amichai-bd/riscv-multi-core-lotr/doc/UART_IO_doc/README.md

This folder should contain all the UART_IO documentation
