amichai-bd/riscv-multi-core-lotr/doc/UART_IO_doc/UART_tile.pptx

Oogway UART Tile

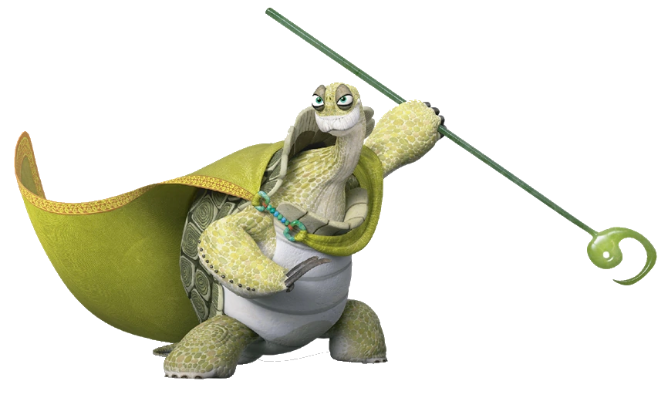
[picture p1: figure]

Chris Shakkour
Shahar Dror

## Introduction

- The UART tile project is a part of a bigger project called the LOTR
- A multi-core design project featuring a ring-like architecture to connect all the cores/tiles in a ring
- the UART tile is here to provide communication from host devices to the LOTR

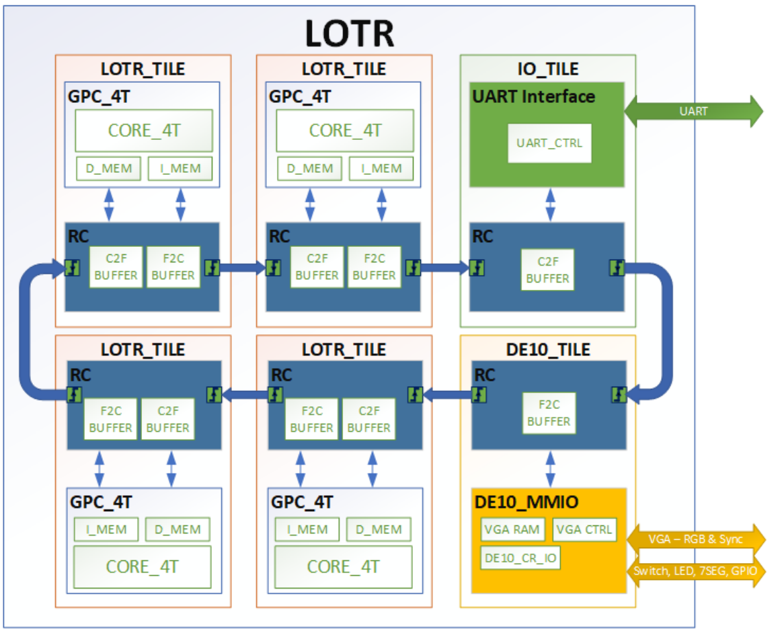
[picture p2: figure]

## System level Connection

The HW interface of the project serves as the blue part in this diagram and the SW interface serves as the green part

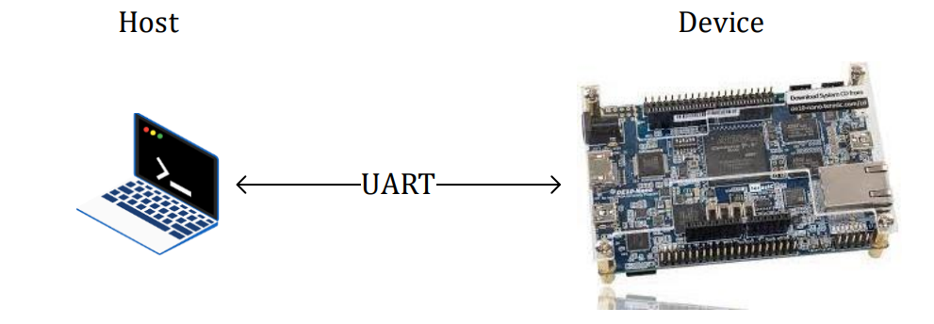
[picture p3: figure]
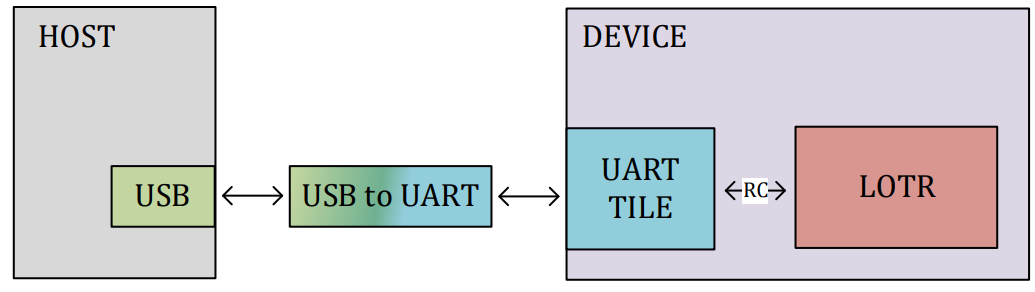
[picture p4: figure]

## Demo

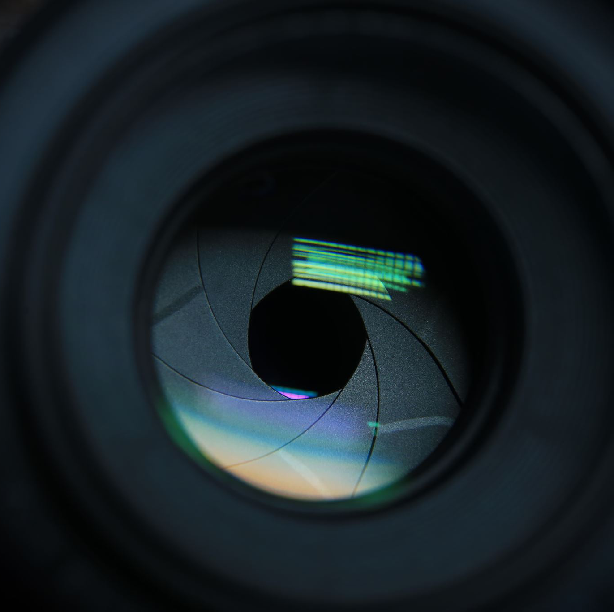
[picture p5: figure]
Camera lens close up

## HW-SW interface

The following diagram shows the different abstraction levels within each interface, both interfaces SW, and HW have multiple abstraction levels as seen below.

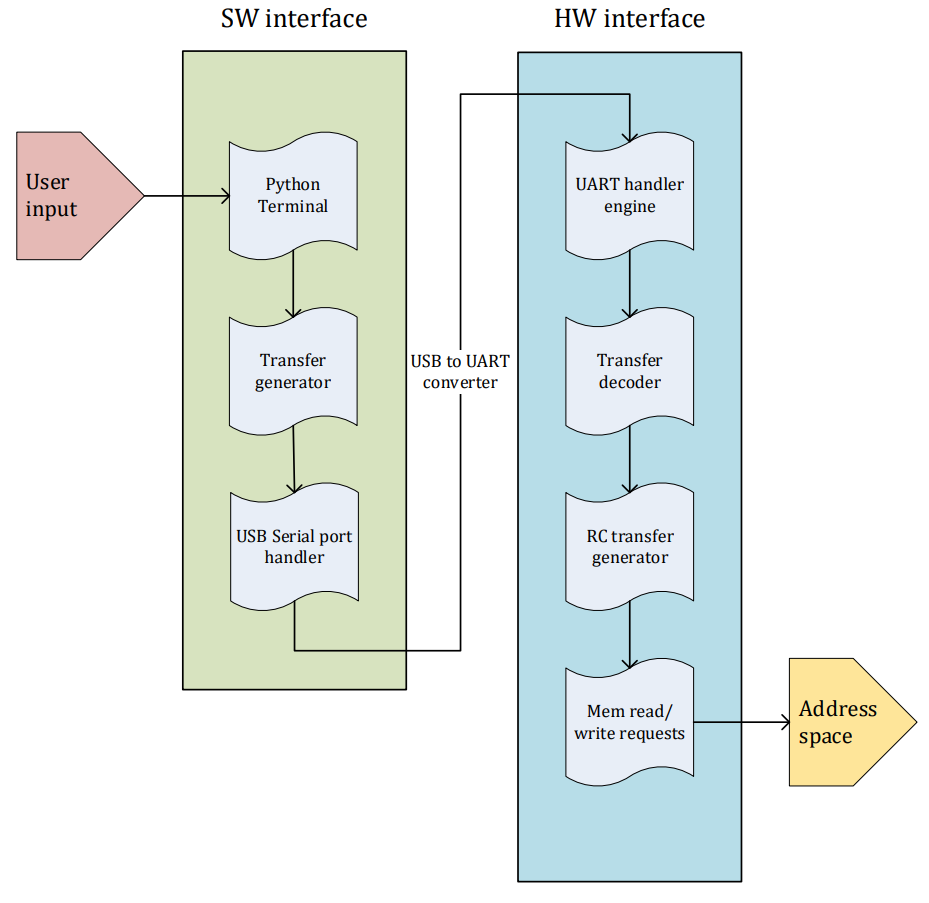
[picture p6: figure]

## SW Interface

- The software interface is the code running on a Host device
- The software does two main functions:
  1. Decode user input.
  2. Generate “Host to Device” transfers.

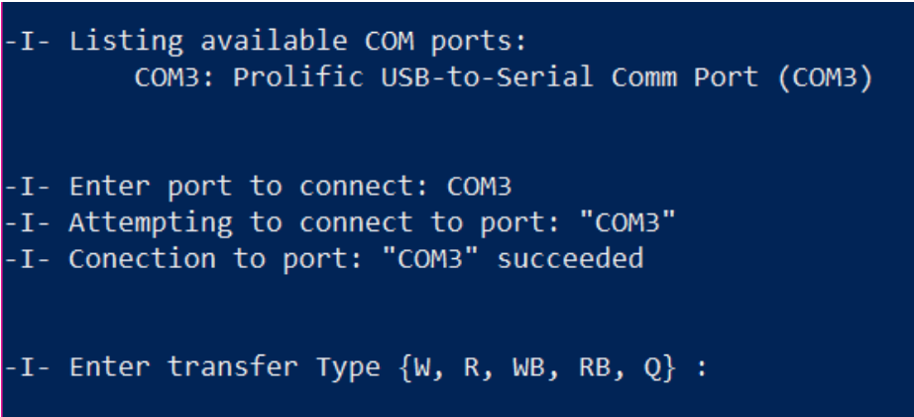
[picture p7: figure]

## Host to Device Transfers

- All transfers are initiated by the Host only.
- The Host starts the transfer and waits for a response from the Device or expire upon timeout.
- Each transfer starts with one byte indicating the transfer type followed by ‘N’ bytes with the required information:
  - transfer address
  - data from Host to Device
- For each transfer, a series of bytes is responded from the Device starting with ‘K’ followed by “M” bytes of response information.

## Write transfer

Initiated by the Host with a starting byte ‘W’, Followed by 8 bytes consisting of, 4 bytes representing the transfer Address, and 4 bytes of transfer data. After a successful transfer, the Device responds with a byte of “K” in ascii indicating transfer completion.

## Read transfer

Initiated by the Host with a starting byte ‘R’, Followed by 4 bytes representing the transfer Address. After a successful transfer, the Device responds with a byte of “K” in ascii indicating transfer completion, followed by 4 bytes of response Data.

## Write burst transfer

Initiated by the Host with a starting byte ‘W’, Followed by Many bytes consisting of, 4 bytes representing the transfer Address, 4 bytes representing the transfer Size and 4*Size bytes of transfer data. After a successful transfer, the Device responds with a byte of “K” in ascii indicating transfer completion.

## Read burst transfer

Initiated by the Host with a starting byte ‘W’, Followed by Many bytes consisting of, 4 bytes representing the transfer Address, 4 bytes representing the transfer Size. After a successful transfer, the Device responds with a byte of “K” in ascii indicating transfer completion, followed by 4*Size bytes of response data.

## Low-level communication diagram

- The transfers are sent in asynchronous serial communication protocols from the host via the USB line and the UART line
- Then translated to reg access transfers passing through the wishbone
- After that the gateway communicates with the RC interfaces
- The way back to the HOST in the opposite direction

## Hardware interface

- The UART tile connects to the Ring using the RC block, the RC block communicates with the Gateway module that acts as a conversion bridge between the UART transfers and the RC transfers.

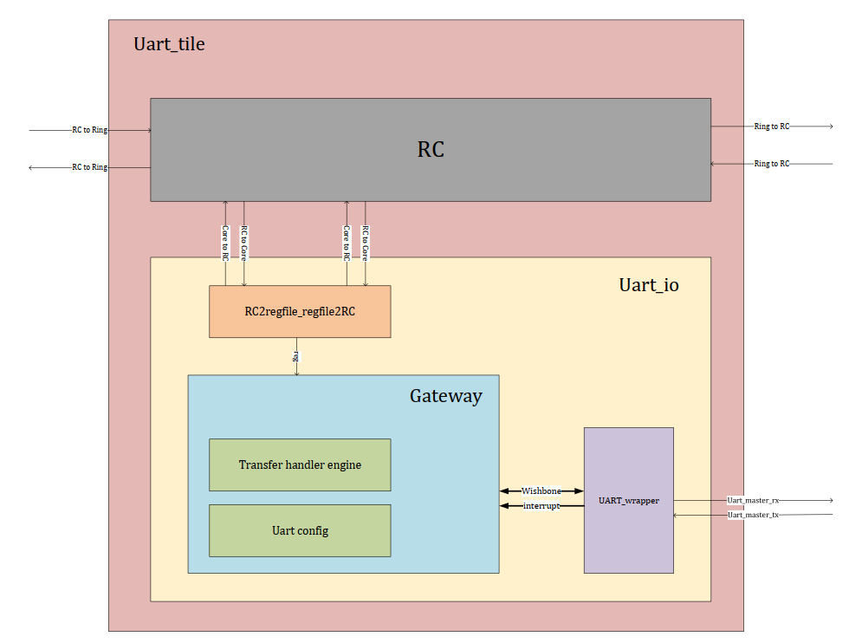
[picture p8: figure]

## Ring controller (IP)

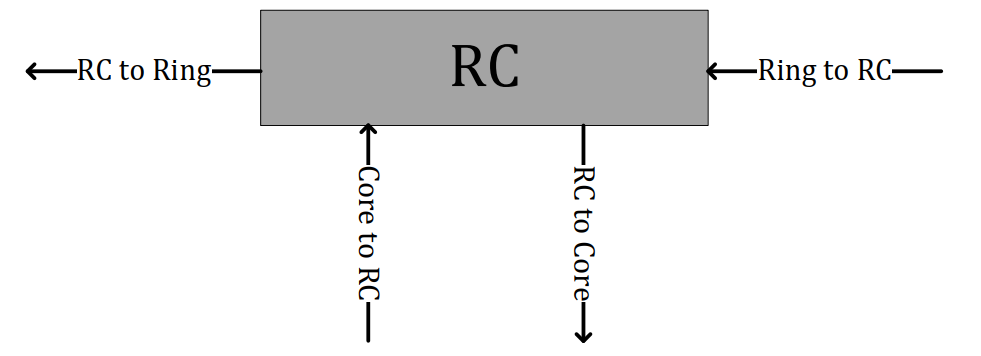
[picture p9: figure]
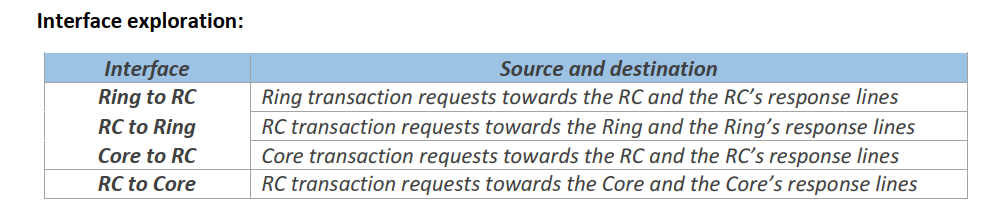
[picture p10: figure]

## Configuration FSM

- An FSM that handles the configuration flow and goes to sleep after config flow is done.
- configuring the UART IP via a series of wishbone reads and writes to set the configuration registers with the desired values:
  - Baudrate
  - word length
  - Interrupt configuration

## Transfer handler engine

- This unit is responsible for decoding the transfers sent by the Host after the translation to wishebone
- The FSM to convert them to direct access register transfers.
- The address and data information are sent in parallel in a single cycle to the Reg2rc conversion unit that then moves this transfer forward to the RC controller

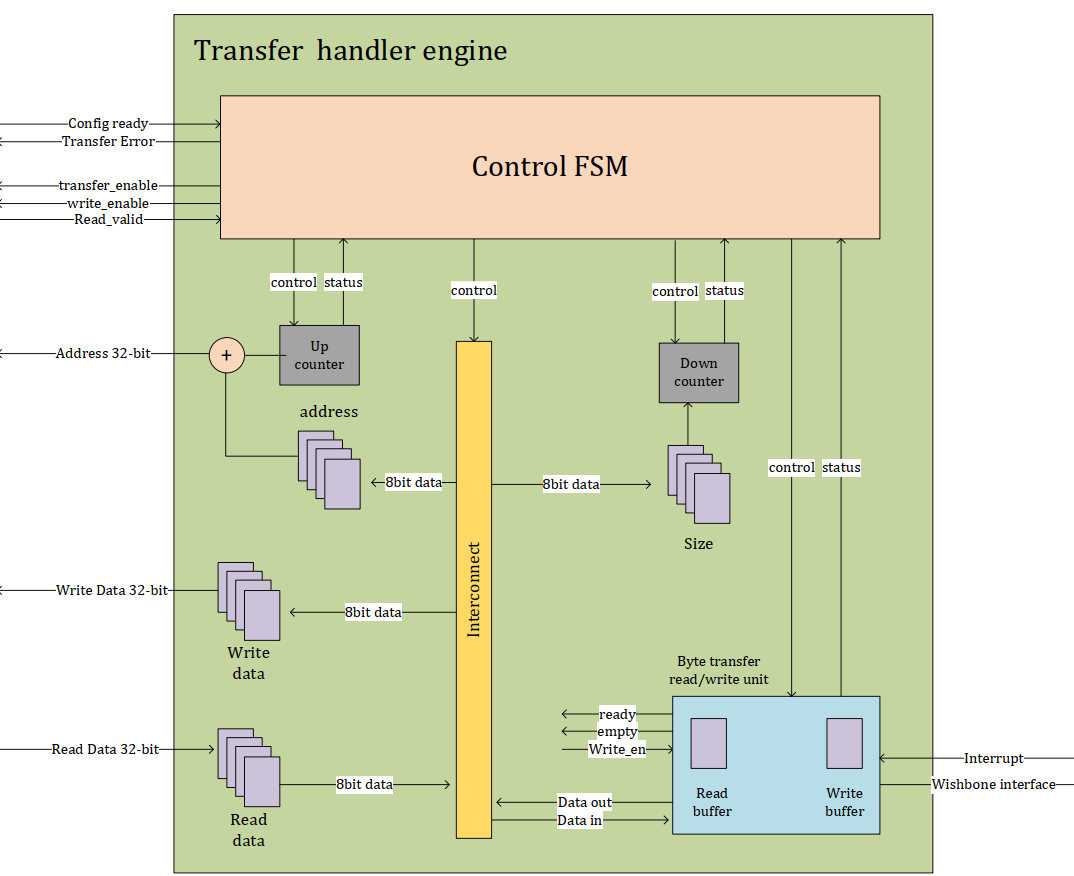
[picture p11: figure]

## FSM examples write

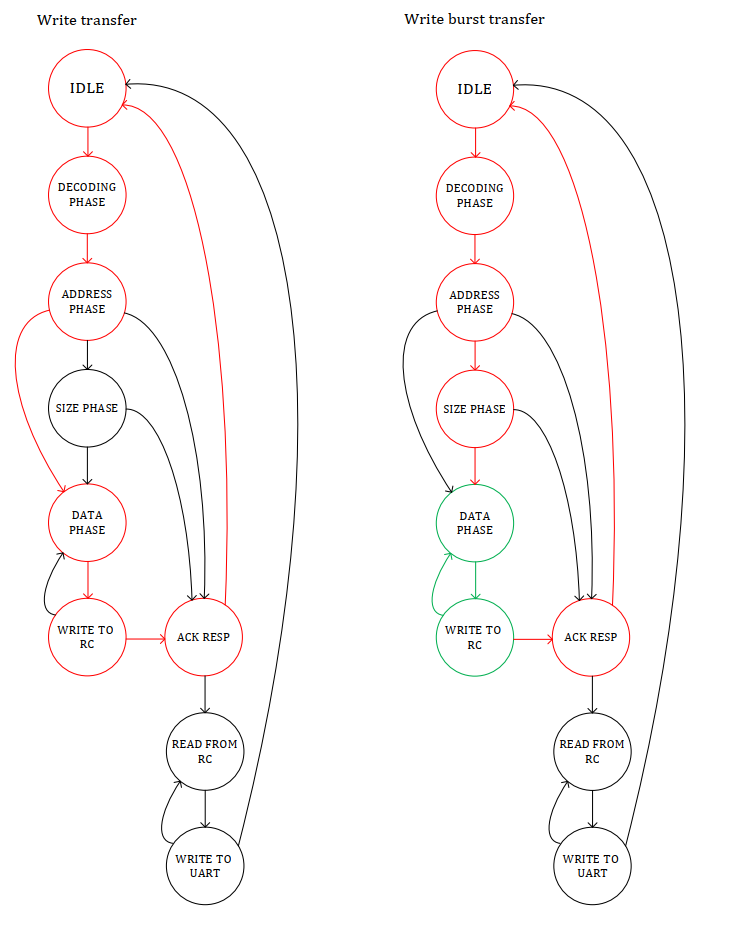
[picture p12: figure]

## FSM examples read

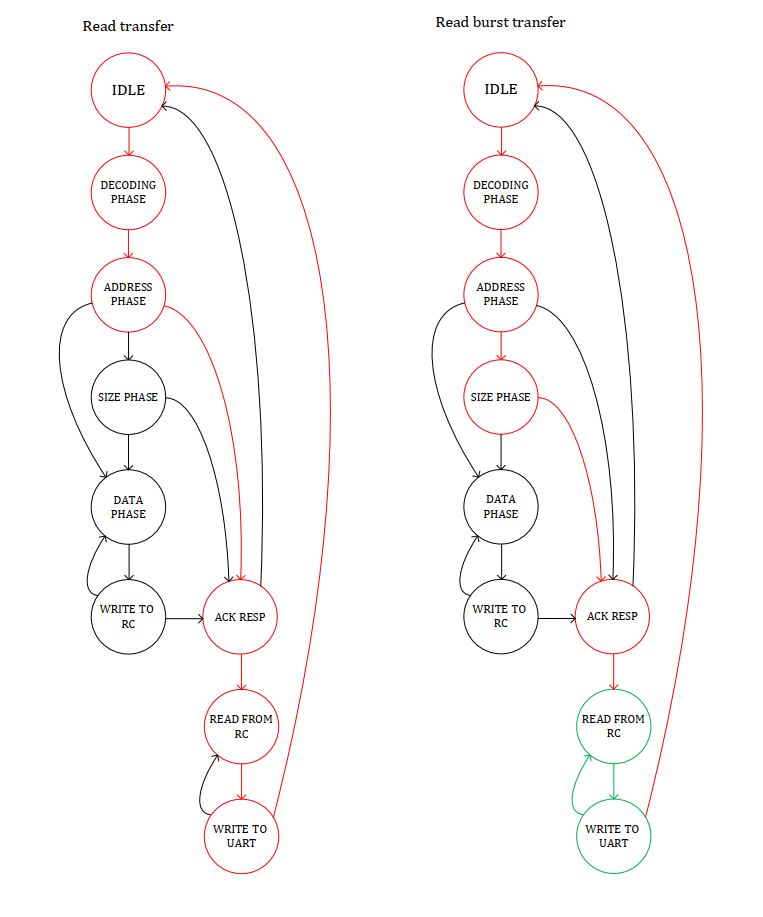
[picture p13: figure]

## Verification and Validation

- Block-level RTL simulations.
- System-level RTL simulations.
- SW Emulators using Arduino and other platforms.
- Realtime system validation.

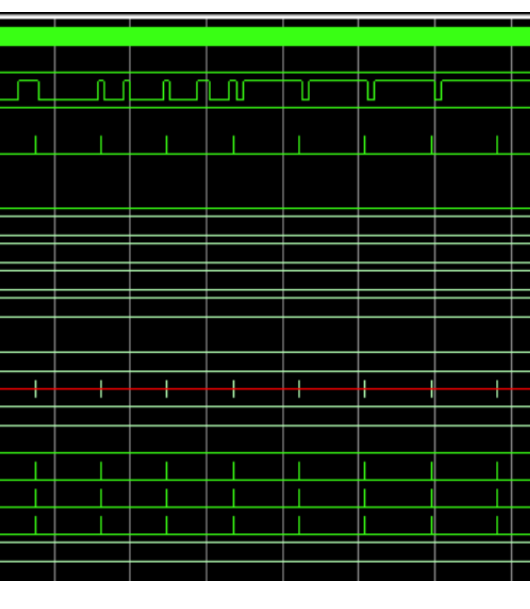
[picture p14: figure]

## Verification and Validation

- System level simulations

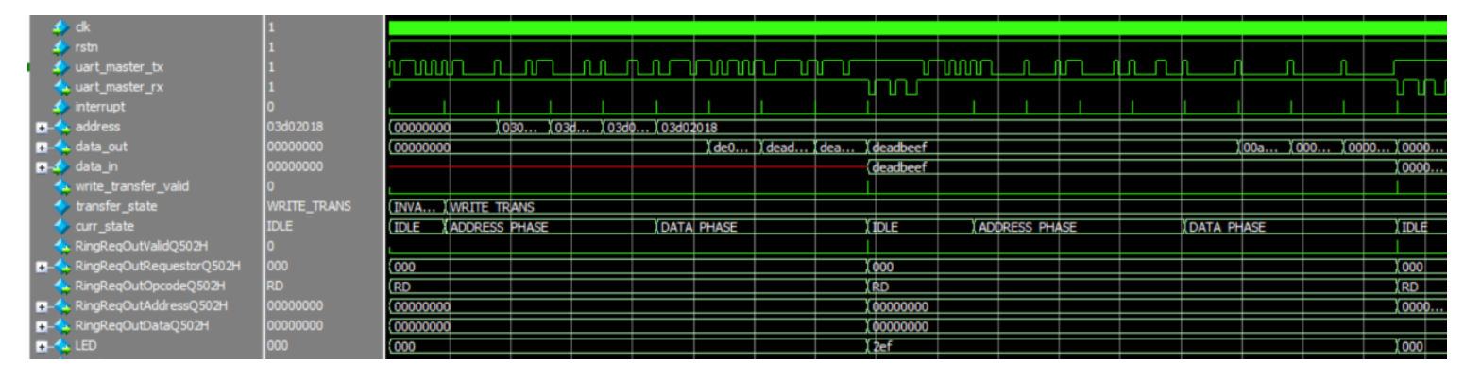
[picture p15: figure]

## Functional validation

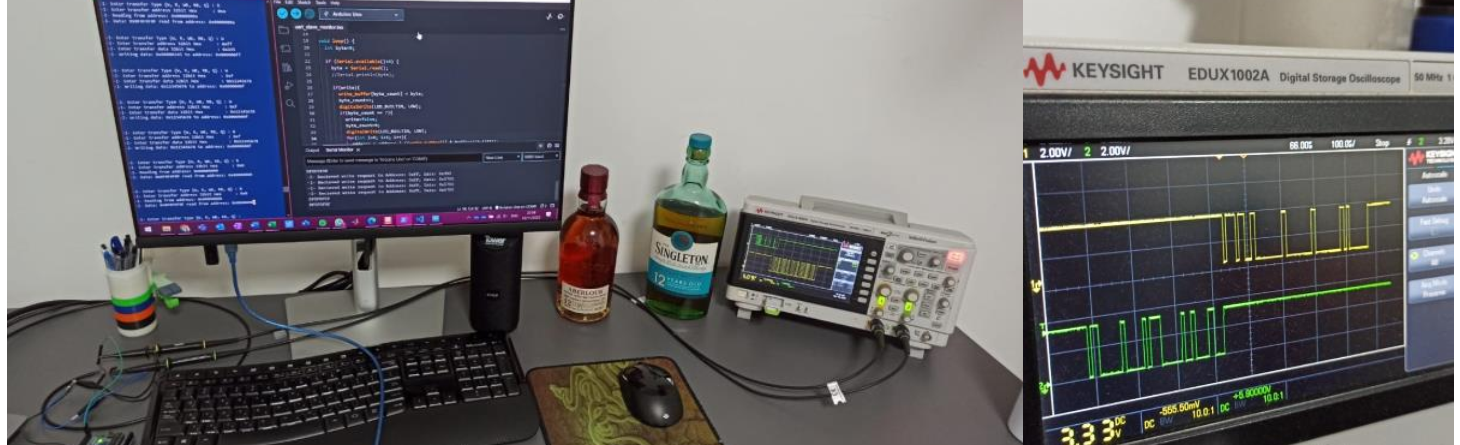
[picture p16: figure]

- The functional validation has been done using an Oscilloscope to monitor the UART RX and TX lines using these two lines one can observe the transactions being sent to and from the device.

## FPGA AREA REPORTS

The area reports have been done on a 50Mhz clock while using the INTEL Quartus prime software

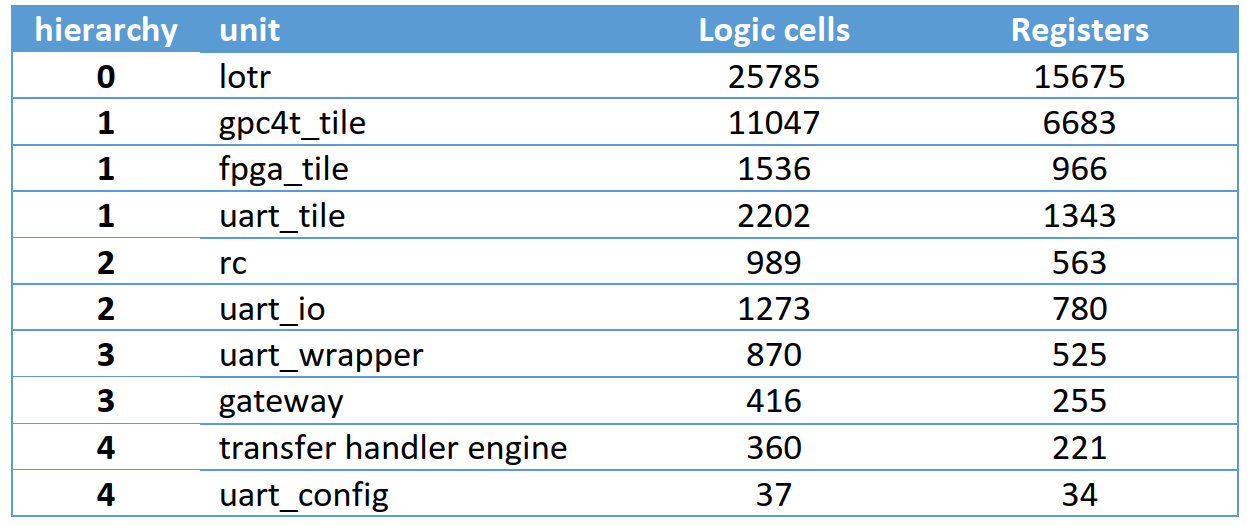
[picture p17: figure]
