amichai-bd/riscv-multi-core-lotr/doc/GPC_4T_doc/GPC_4T Development & Methodologies.docx

# GPC_4T: Development & Methodologies

Development Environment and Methodologies used during gpc_4t solution

Adi Levy (adi.levy@campus.technion.ac.il)

Saar Kadosh (skadosh@campus.technion.ac.il)

# Contents

Revision History

Rev. No. | Who | Description | Rev. Date
0.1 | Adi Levy | Initial GPC_4T Dev & Methodologies | 06 November 2021

Figures

# 1 Git & GitHub

## 1.1 Git

Git is a well-known software for tracking changes in any set of files. we used git to clone our project files to our personal computers , work on them simultaneously and then upload them to our common cloud stored in github.com. Git also used us for solving "merge conflicts" and track changes.

## 1.2 GitHub

GitHub is a free provider of Internet hosting for software development and version control using Git.
We used GitHub to store our "repository" which include all the project files, in addition to the parallel Ring Controller project files and the LOTR files developed by our advisor Amichai.

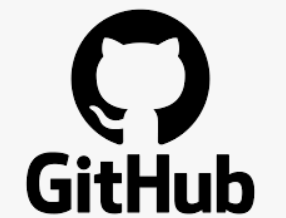
[picture p36: figure]

Figure 1 - github logo

# 2 LOTR Repository structure

The repository was maintained mostly by Amichai and he is the biggest contributor to the hub.
In addition to storing our files and tracking old version using git, the GitHub also include many aspects:

- Code & Code Review : each contributor can upload his code and receive code review before the new uploaded code is merged with the complete repository code .

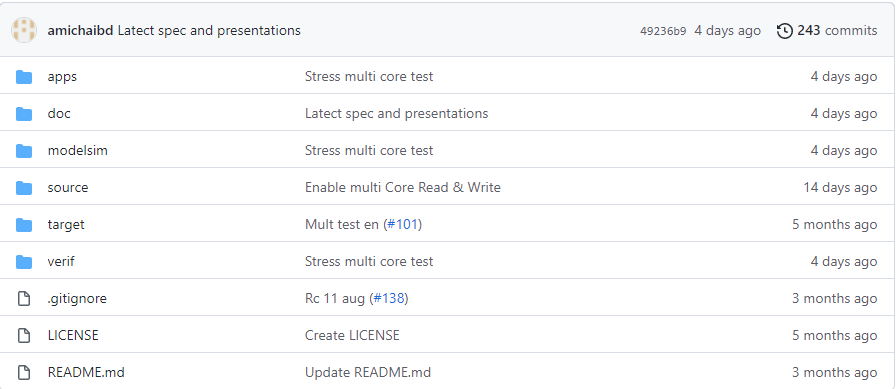
[picture p37: figure]
תמונה שמכילה טקסט התיאור נוצר באופן אוטומטי

Figure 2 - LOTR complete repository code, including GPC_4T code as seen on GitHub

- Task Management : used by "issues" tab on git lab. Each meeting with the advisor we assign tasks between us and detailed about the task in its page.

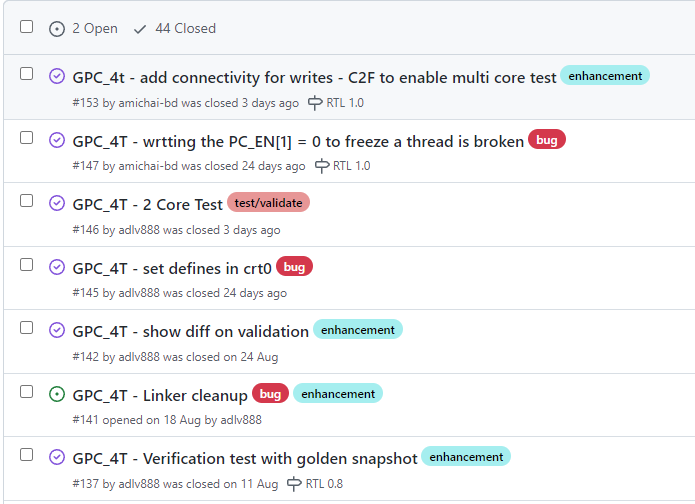
[picture p38: figure]
תמונה שמכילה טקסט התיאור נוצר באופן אוטומטי

Figure 3 - Project tasks as showen on GitHub

- Discussions and Questions : every time we encountered a problem in our work , we wrote about it in the Discussions tab. one of the many contributors to one of the projects can answer if knows.

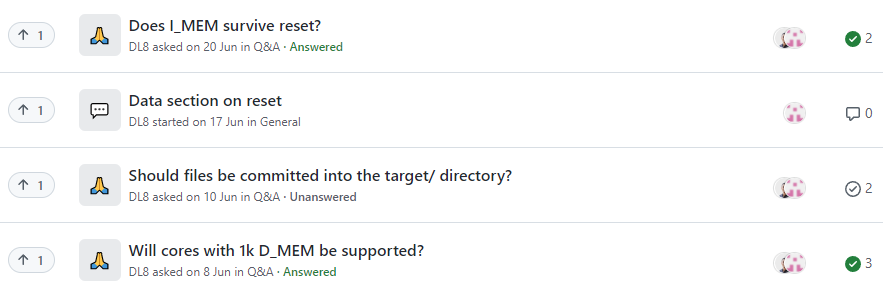
[picture p39: figure]
תמונה שמכילה טקסט התיאור נוצר באופן אוטומטי

Figure 4 - Questions & Discussions on GitHub repository

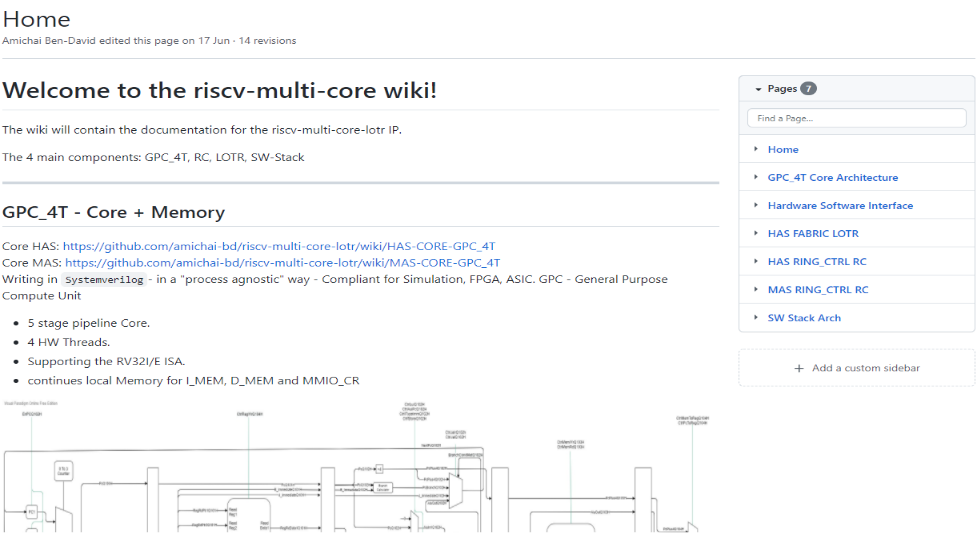
[picture p40: figure]

- Wikia : An edit free wiki pages were maintained by the GitHub contributors. The idea was to create a data base of knowledge for each piece of the LOTR project, including the GPC_4T. Many of information and figures mentioned in this book was written by us in this wiki during the work on the project.

Figure 5 - Project's wiki on GitHub

# 3 RISC-V GNU Compiler Toolchain

The Toolchain is a bundle of software tools cloned from "riscv-gnu-toolchain" Git repositories .It was use to create & verify assembly instructions against the open-source ISA specification for an RV32IM core.

A detailed installation guide can be found in this link (https://github.com/johnwinans/riscv-toolchain-install-guide) on John Winans repository.

## 3.1 WSL

The Toolchain installed on WSL environment , which is a windows subsystem that behaves much like a Linux kernel, on top of it can be installed real GNU/Linux distribution. In our case Ubuntu OS installed.
There are alternatives by using RISC V compilers on Windows OS environment.

## 3.2 GCC

In simplicity, the Toolchain contains several of special compilers based on the famous gcc compiler family and we use it to make from a ".c" file written in C language to a RISC-V Assembly Language file (.S) , and from that file, to a binary .sv file that will simulate the instruction memory GPC_4T can read. The toolchain also generates these files as text files that the user can read.

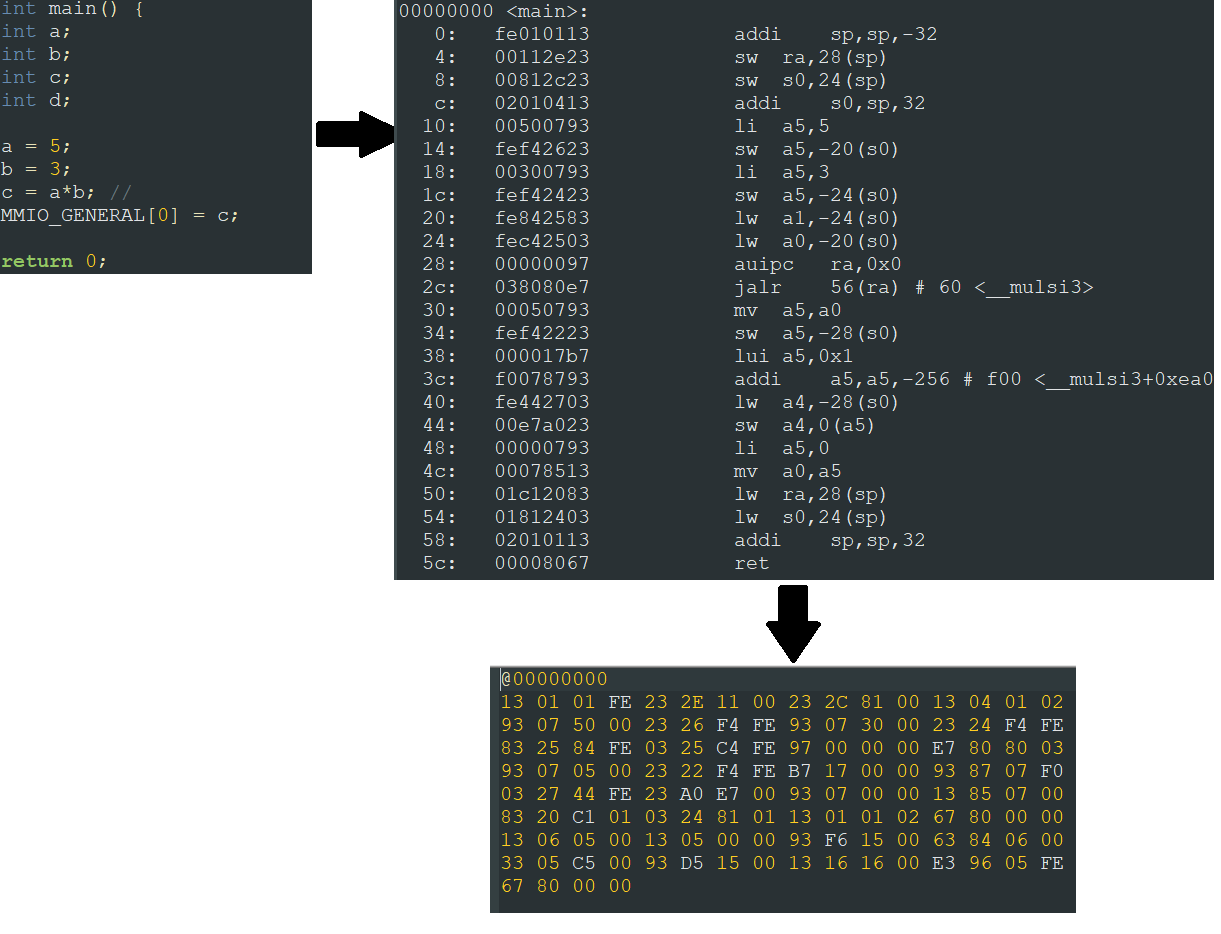
[picture p41: figure]

Figure 6 - Toolchain compiling example : clockwise - C program converted to assembly converted to sv binary code

As seen as figure 3, the C program converted to RiscV assembly commands. the assembly code is longer than the C code. each assembly command is coded in a 32bit vector (or 8 hexadecimal digit vector in the text file). all vectors combined to form the simulation instruction memory (bottom image). The GPC_4T decodes each vector as will described in upcoming sections.
The SV text file will used as an instruction memory to the GPC_4T in the simulations via "Back Door" technique will discussed in Validation section.

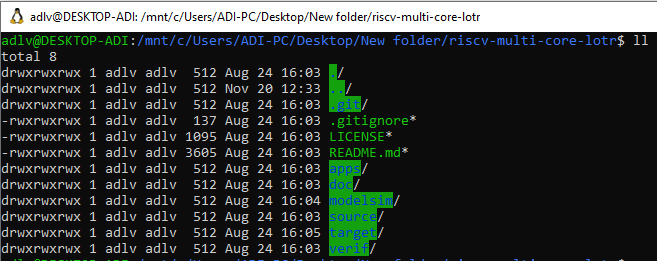
[picture p42: figure]
תמונה שמכילה טקסט התיאור נוצר באופן אוטומטי

Figure 7 - WSL Ubunto Shell showing project files

after installing Toolchain on the WSL, we used the shell in order to run a series of commands to run the special Toolchain RiscV compilers & Linkers to get all necessary files from C file.

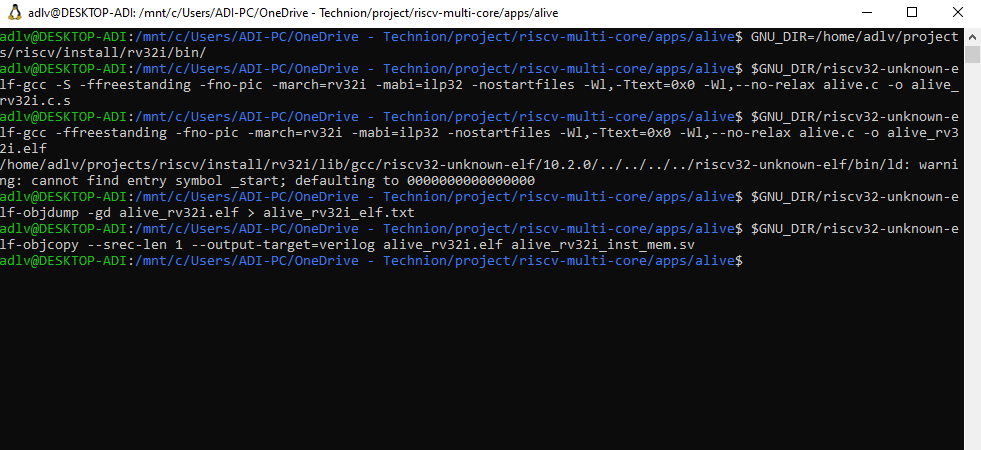
[picture p43: figure]
תמונה שמכילה טקסט התיאור נוצר באופן אוטומטי

Figure 8 - ToolChain commands use example on alive.c

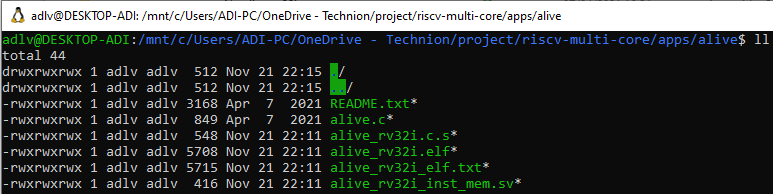
[picture p44: figure]
תמונה שמכילה טקסט, צג, צילום מסך, מסך התיאור נוצר באופן אוטומטי

Figure 9 - Created files from alive.c after Figure FIXME commands

# 4 System Verilog

System Verilog is a hardware description language(HDL) used to model, design, simulate, test and implement electronic systems. SV can used to describe hardware behavior so that it can be converted to digital blocks made up of combinational gates and sequential elements.
the Gpc_4T RTL(Register-Transfer Level) was written in System Verilog.

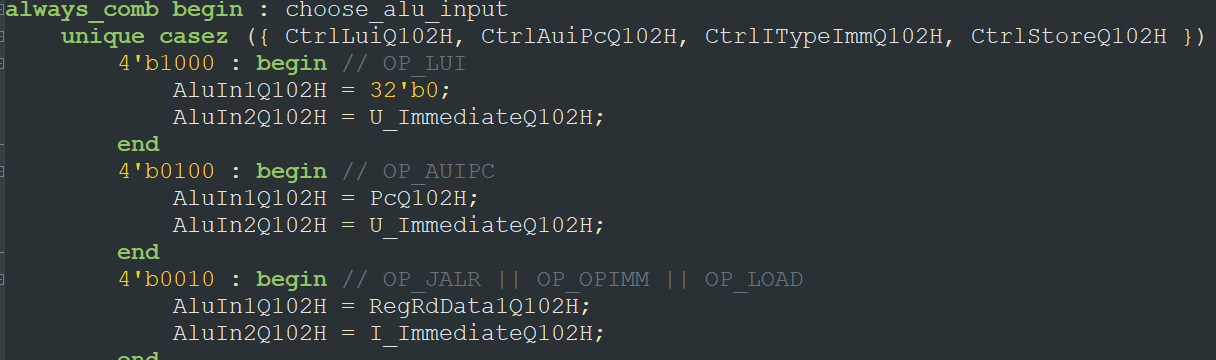
[picture p45: figure]
תמונה שמכילה טקסט התיאור נוצר באופן אוטומטי

Figure 10 - System Verilog code example from GPC_4T source code, showed on notepad++ text editor

## 4.1 Project Coding Style

Thru the entire System Verilog programming of the RTL, we used a coding style that was coherence to the entire LOTR projects (GPC_4T, RC and LOTR itself).

- Macros: On system Verilog, when you want do design a flip-flop it is known to use this convention:  In a file named lotr_defines.sv we set our defines for flip-flops. For example to use the flip-flop on the convention above, we use the define :

`define LOTR_EN_RST_MSFF(q,i,clk,en,rst)

thus every time we need to use this we write with this define

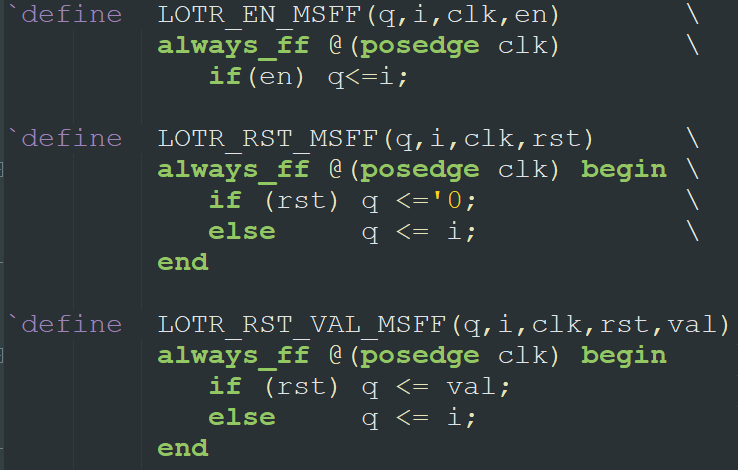
[picture p46: figure]

Figure 11 - lotr defines examples

- CamelCase – we used CamelCase coding style convention to name the variables ,logic signals, wires, buffers etc. thru all of the RTL files. On this convention we name the variables like this: SomeNameOfTheLogic with no spaces with each word starts Sometimes a combination of CamelCase and snake_case used when we felt some logic names belong to the same family, for example : C2F_RspValidQ502H C2F_RspOpcodeQ502H

C2F_RspThreadIDQ502H

C2F_RspDataQ502H

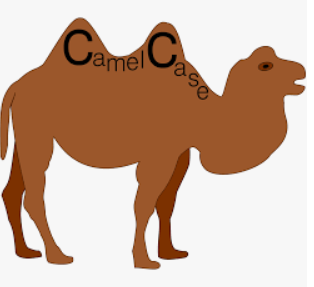
[picture p47: figure]

Figure 12 – Double-humped Bactrian camel

- Lotr_pkg – all the LOTR project parameters were defined in a file named lotr_pkg.sv. Many parameters such as Op Codes, CR addresses, Memory sizes, offsets, MSB and LSB locations, region(core id) bits location, encoded region(I mem, d mem, cr mem) bits, structs(like core_cr struct) and more were defined there and can be used on all RTL files.

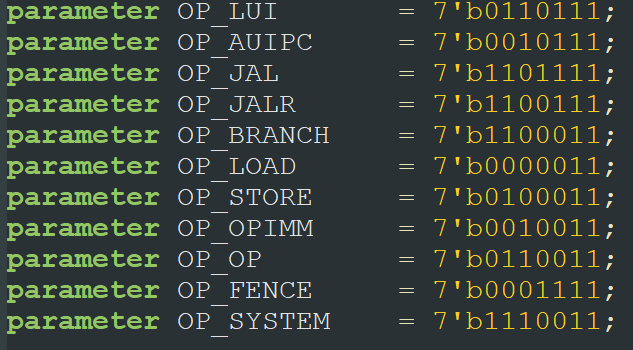
[picture p48: figure]

Figure 13 - RV32I commands op code parameters from lotr.pkg

- Cycle Suffix – To make development easier, we labeled each signal name with a suffix implying the pipeline stage this signal is used, generated, or sampled. after the signal sampled in flops, its suffix increased by 1. Any signal can be used anywhere on the cycle but that is our convention. For example, AluOutQ102H is the ALU output signal on stage Q102H and when it used in stage Q103H it will be sampled on flop and will be named AluOutQ103H

Figure 14 - signals form Q102H stage, sampled before used in Q103H stage

# 5 ModelSim

ModelSim is a multi-language environment for simulation of hardware description languages such as VHDL, Verilog and SystemC. Simulation is performed using the graphical user interface (GUI), or automatically using scripts. [Wikipedia]

We first exposed to ModelSim in Digital Systems Course when we used it to program and simulate logic gates.
On the GPC_4T project we used ModelSim in the Validation process to simulate the GPC_4T core and the memories using the System Verilog RTL files. One the first steps of the project, we used the GUI form of ModelSim , especially in the Waveform GUI in order to debug and track signals ,but as the project progressed, we used automation scripting to simulate.

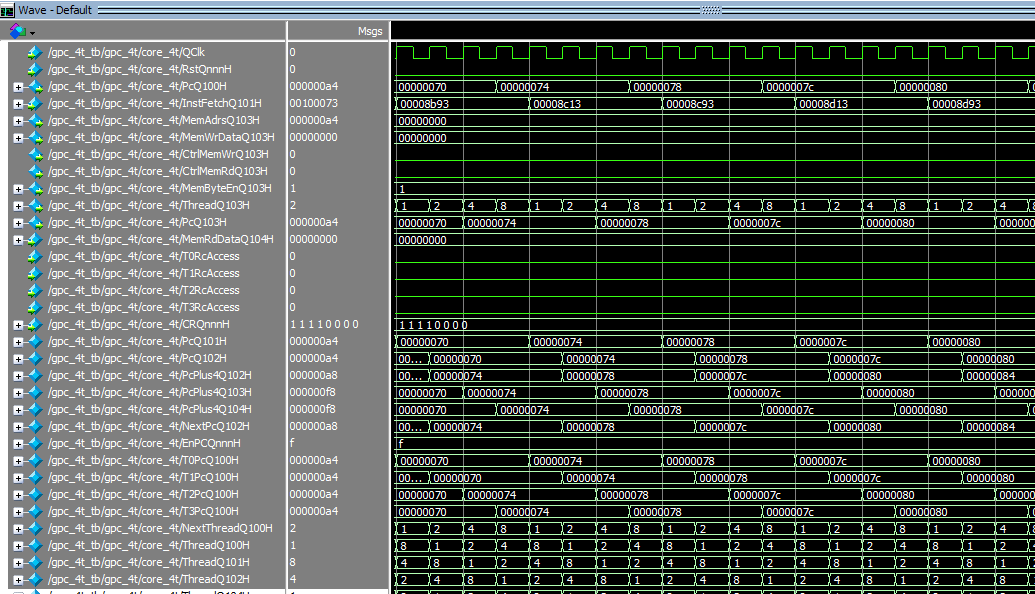
[picture p49: figure]

Figure 15- ModelSim Waveform simulation of GPC_4T core

more details on the simulations on Validation chapter.

# 6 PowerShell & Bash

Two famous automation work environments – Bash for Unix/Linux and PowerShell for Windows , used in the project to enhance the validation stage by scripting. Bash scripts used to enhance the Toolchain workflow and PowerShell used for ModelSim simulation workflow. More detailed information on the automation in the Validation Plan chapter.

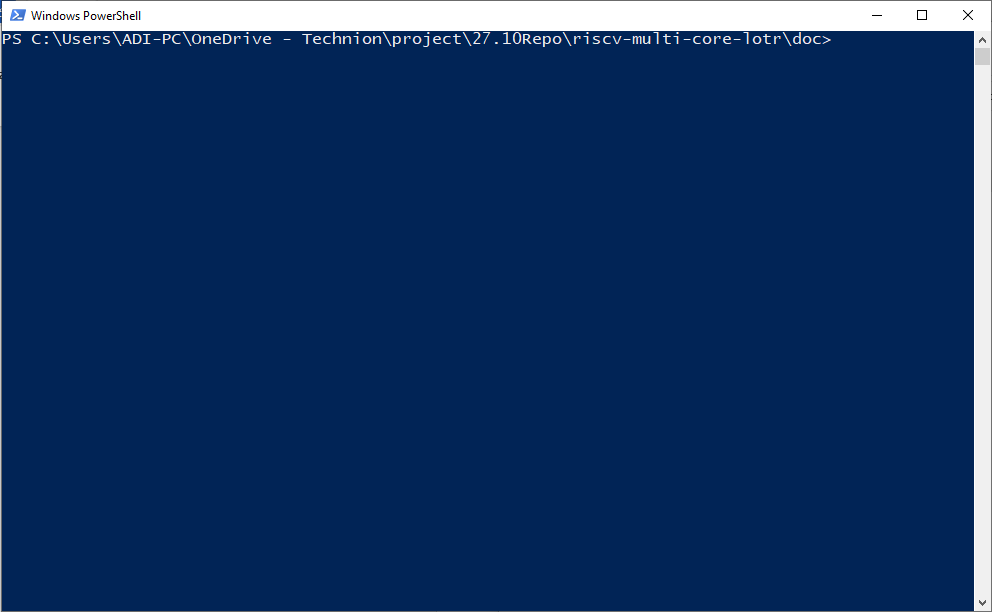
[picture p50: figure]

Figure 16 - Windows PowerShell

gpc_4t Development & Methodologies
