amichai-bd/riscv-multi-core-lotr/doc/LOTR_doc/LOTR_Mid_Sem_Presentation.pptx

## LOTR Based SoC Implantation of an LOTR RV Based SoC on an FPGA

Saar kadosh & adi levy

## Slide 2

Background

- Previous Project: GPC_4T Project
  - Implementation of 4 HW Threads RV32I Core
  - D_MEM_WRAP (D_MEM, CR_MEM) I_MEM_WRAP
  - Integrability to Ring Controller
  - Testing and Validation Environment
- Fully Implementing LOTR
  - Multi Core Ring architecture
  - Testing and Validation

Background

Definition and goals

Architecture

Tools

Status

To Be Done

## Slide 3

Definition And Goals

- Project Goals:
  - Fully design Ring Architecture LOTR
    - Design, test and verification
    - Official RISCV “Compatibility Test”
  - Implementation of the LOTR on FPGA
    - Syntisizable and Compiled on Quartus environment
  - Efficiently execute complex Multi-Core and Multi-Threads programs on the LOTR

Background

Definition and goals

Architecture

Tools

Status

To Be Done

## Lord-Of-The-Ring Architecture

Background

Definition and goals

Architecture

Tools

Status

To Be Done

## GPC_4T Architecture

High Level Architecture Specifications

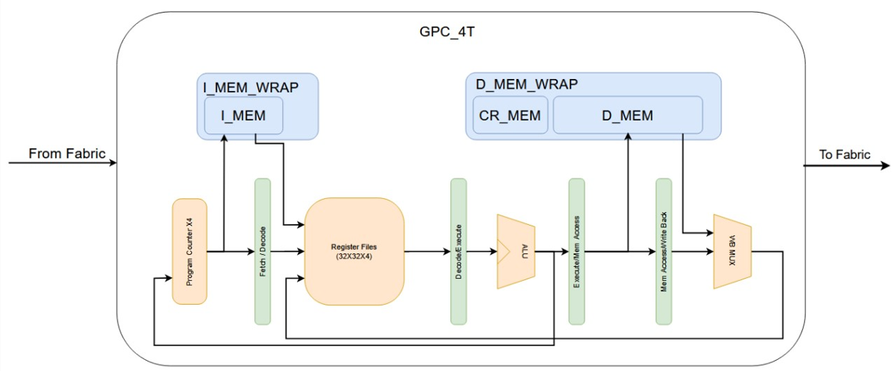
[picture p57: figure]

Background

Definition and goals

Architecture

Tools

Status

To Be Done

## Ring Control Architecture

High Level Architecture Specifications

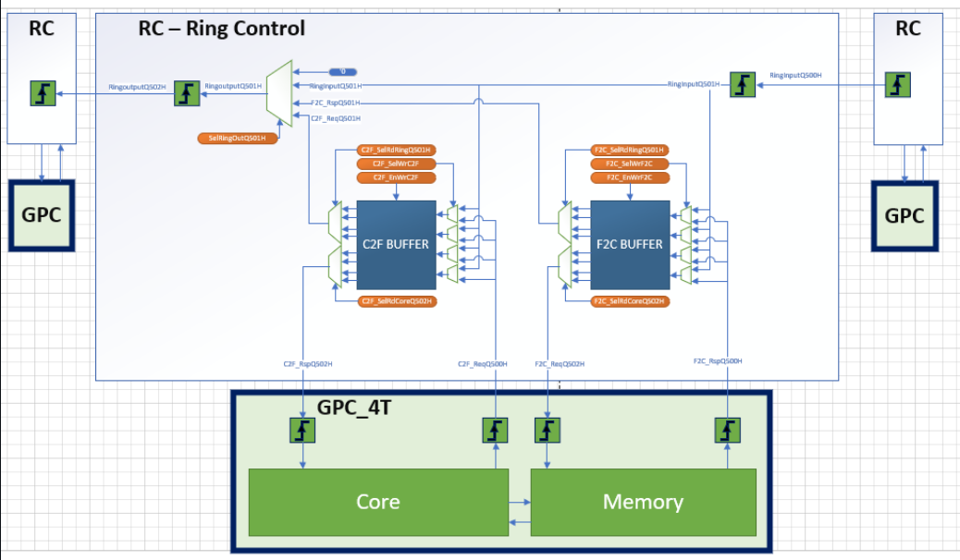
[picture p58: figure]

Background

Definition and goals

Architecture

Tools

Status

To Be Done

## Tools

- Windows based RISCV Tool-Chain
  - C Compile Assembly Linker Assembler Machine code
- SIMULATION – MODELSIM & POWERSHELL
  - Compilation Elaboration Simulation Wave tracker Memory
- gIThUB
- Windows based toolchain
  - Switching from WSL/PS scripts to simple bash scripts

Background

Definition and goals

Architecture

Tools

Status

To Be Done

## Status

- So far we updates the environment to support Fabric and Multi-Core compatibility
  - Test Bench
  - Multi Core Tests
  - Multi Core Scripts
  - RC Interface
  - Thread Stall when reading to Non-Local Memory
  - Writing to Non-Local Memory

Background

Definition and goals

Architecture

Tools

Status

To Be Done

## To Be Done

- Core Optimization
  - Optimization Arch Pipe
  - Support privileged CSR RISCV extension to allow OS
  - Support exception and error detections and interrupts
  - Official RISCV “Compatibility Test”
- Enable more complex Multi-Thread tests
- Test the Design on FPGA:
  - Design and test on Front Door access
  - Design IO Tile and integrate into standard Quartus IO
  - Syntisizable and Timing Conversion
  - Compile and Synthesize design on Quartus environment

Background

Definition and goals

Architecture

Tools

Status

To Be Done

## Question?
