amichai-bd/riscv-multi-core-lotr/doc/GPC_4T_doc/instructions.pptx

## Fantastic – RISC V based General Purpose Compute Unit with 4 physical Threads

Instruction Control Signals

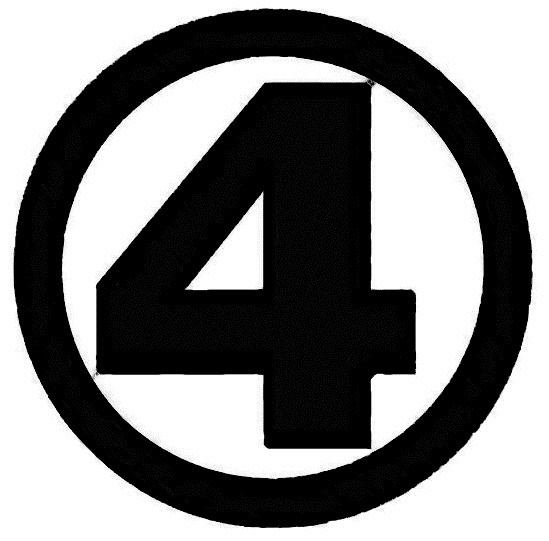
[picture p174: figure]
Fantastic Four Costume Logo (1960s) | Fantastic four logo, Comics logo, Fantastic four

## Supported Instructions

R-Type: | I-Type: | S-Type: | U-Type: | B-Type: | J-Type:
ADD | ADDI | SB | LUI | BEQ | JAL
SUB | SLTI | SH | AUIPC | BNE
SSL | SLTIU | SW | | BLT
SRL | XORI | | | BGE
SRA | ORI | | | BLTU
SLT | ADNI | | | BGEU
SLTU | JALR
XOR | LB
OR | LH
AND | LW
| LBU
| LHU

## Supported Instructions

J-Type | U-Type | B-Type | S-Type | I-Type | R-Type
JAL | LUI | BEQ | SB | ADDI | ADD
| AUIPC | BNE | SH | SLTI | SUB
| | BLT | SW | SLTIU | SSL
| | BGE | | XORI | SRL
| | BLTU | | ORI | SRA
| | BGEU | | ADNI | SLT
| | | | JALR | SLTU
| | | | LB | XOR
| | | | LH | OR
| | | | LW | AND
| | | | LBU
| | | | LHU

## Slide 4

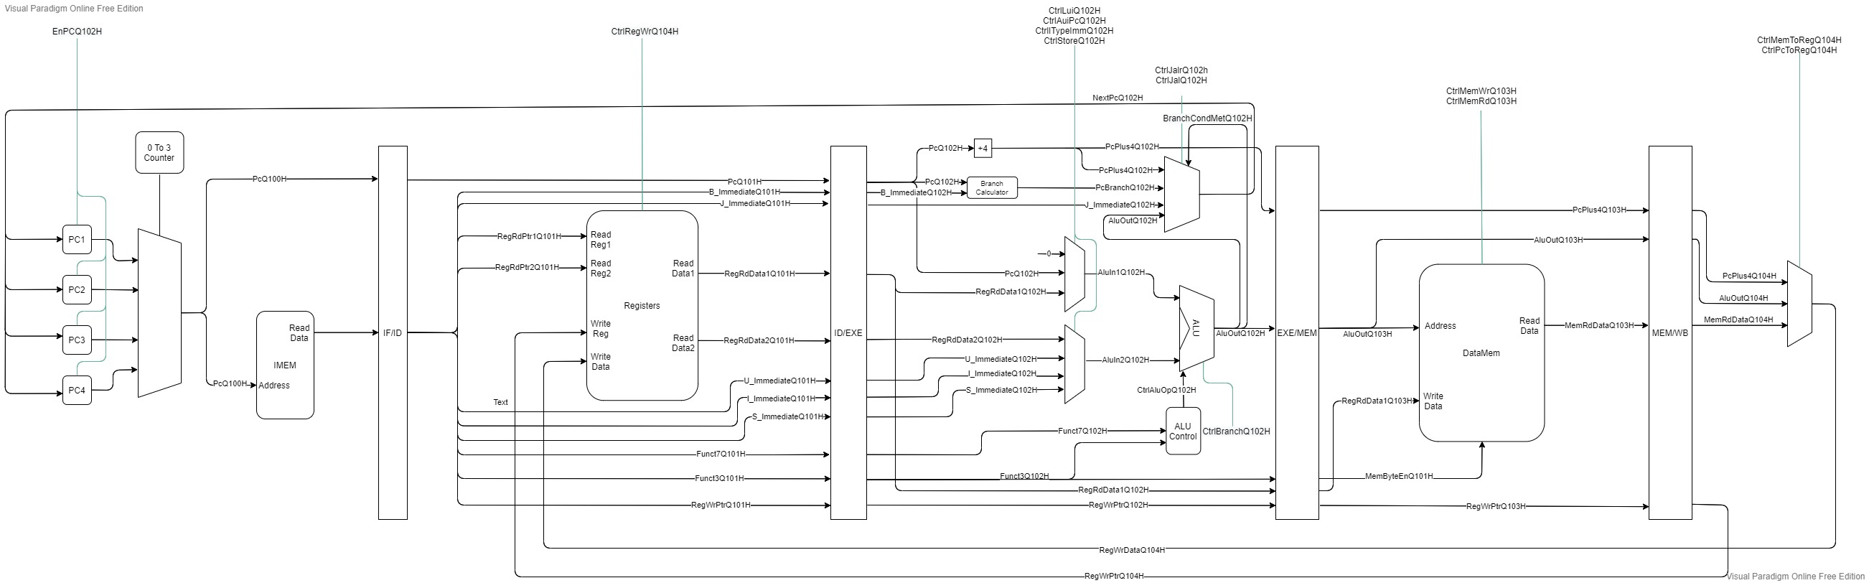
[picture p175: figure]

## Integer Reg-Imm Instruction

## ADDI, SLTI, ANDI, XORI, ORI

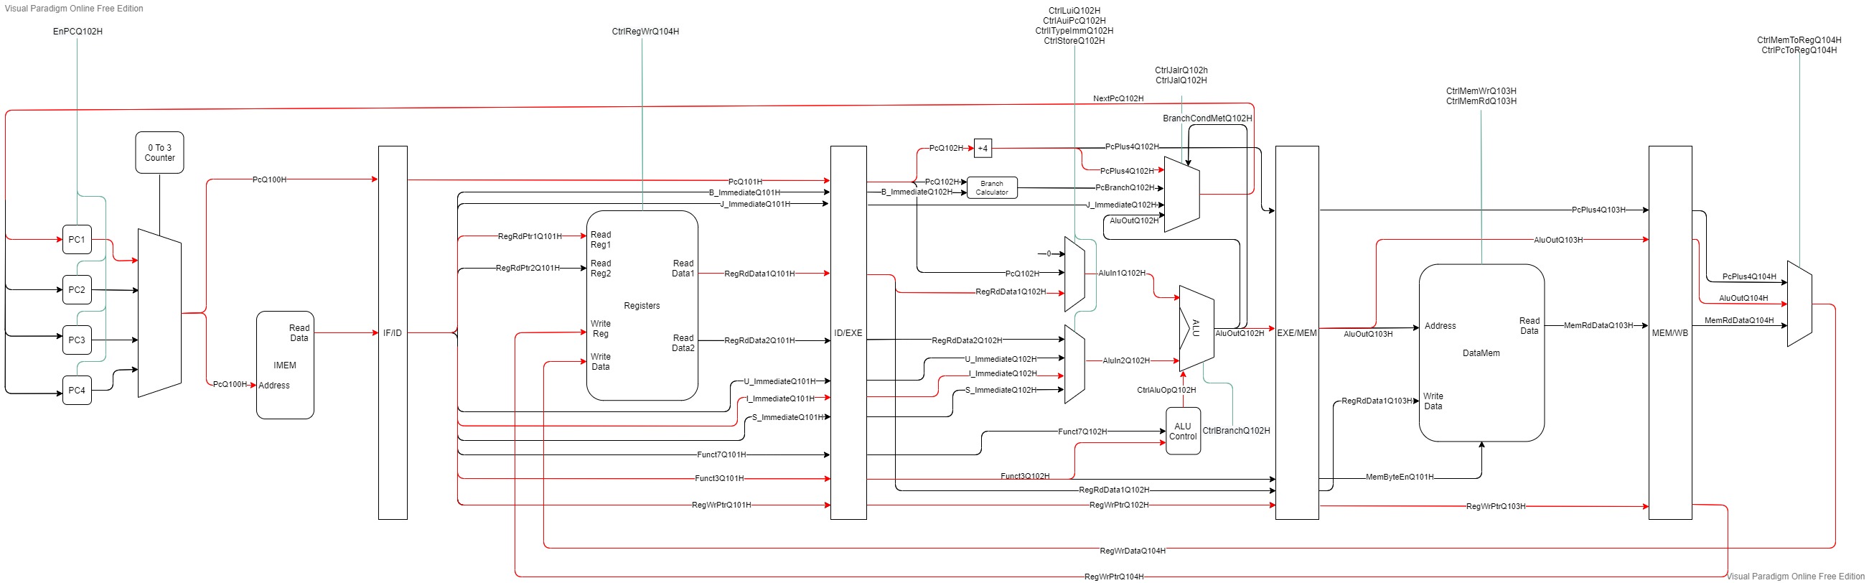
[picture p176: figure]

## SLLI, SRLI, SRAI

## LUI, AUIPC

## Integer Reg-Reg Operation

## ADD

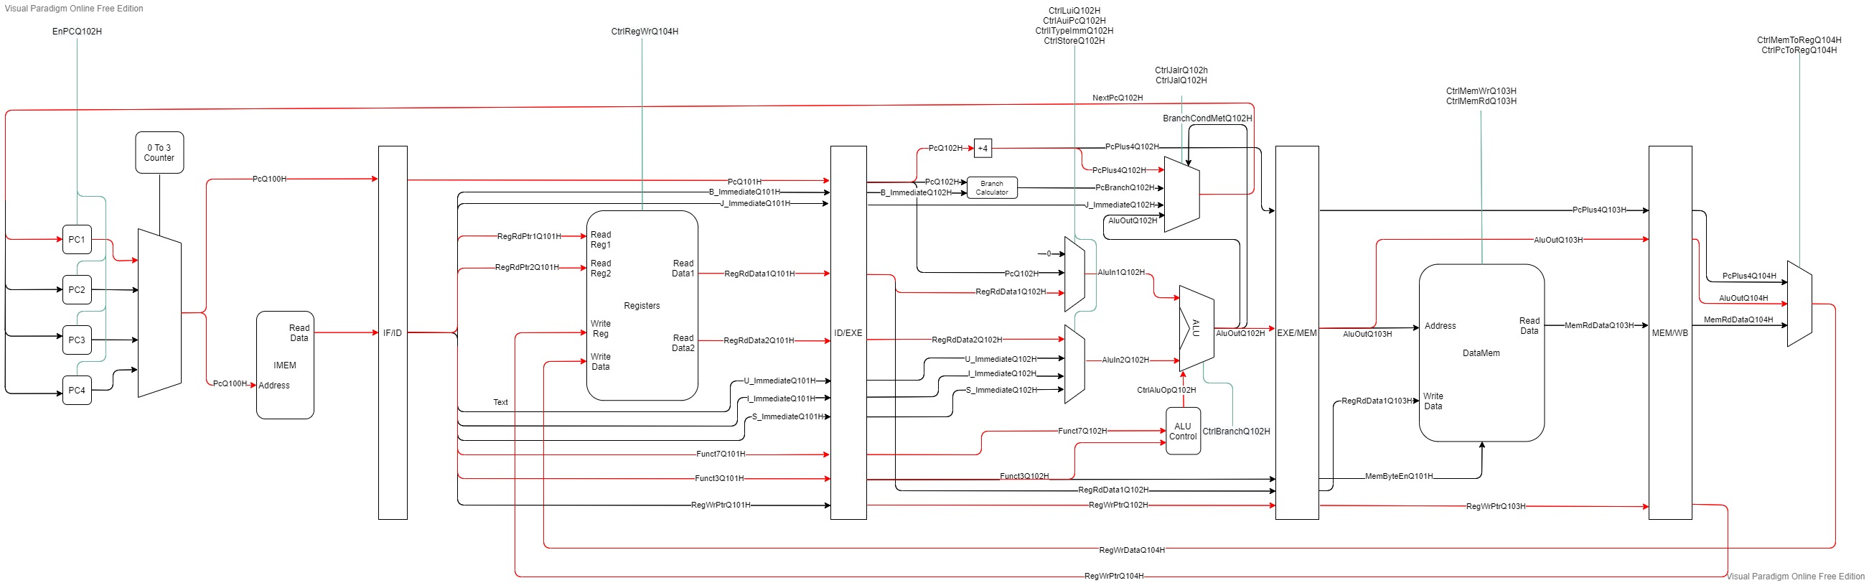
[picture p177: figure]

## SLT

## SLTU

## AND

## OR

## XOR

## SLL

## SRL

## SRA

## SUB

## NOP

## Unconditional Jumps

## JAL, JALR

## Conditional Branch

## BEQ, BNQ, BLT, BGE

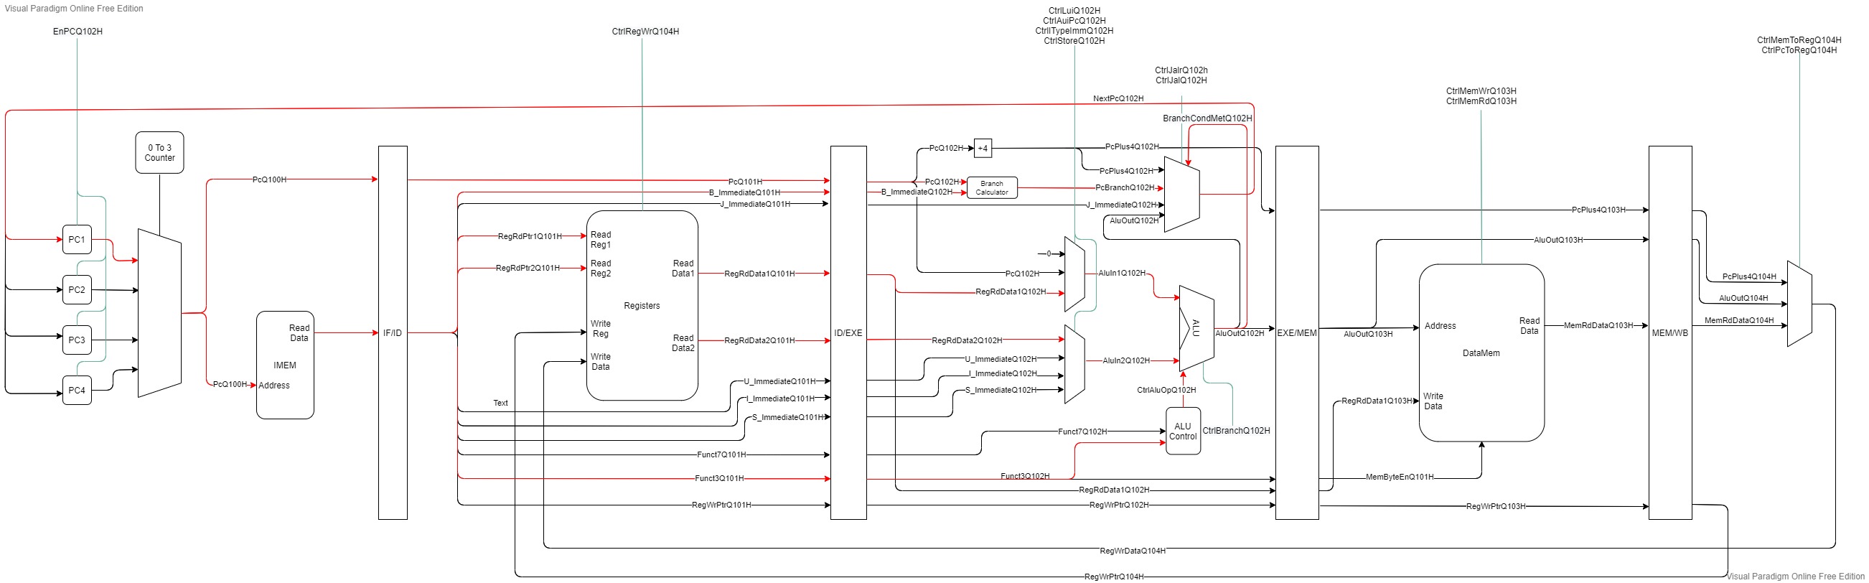
[picture p178: figure]

## Load/Store Instructions

## Store

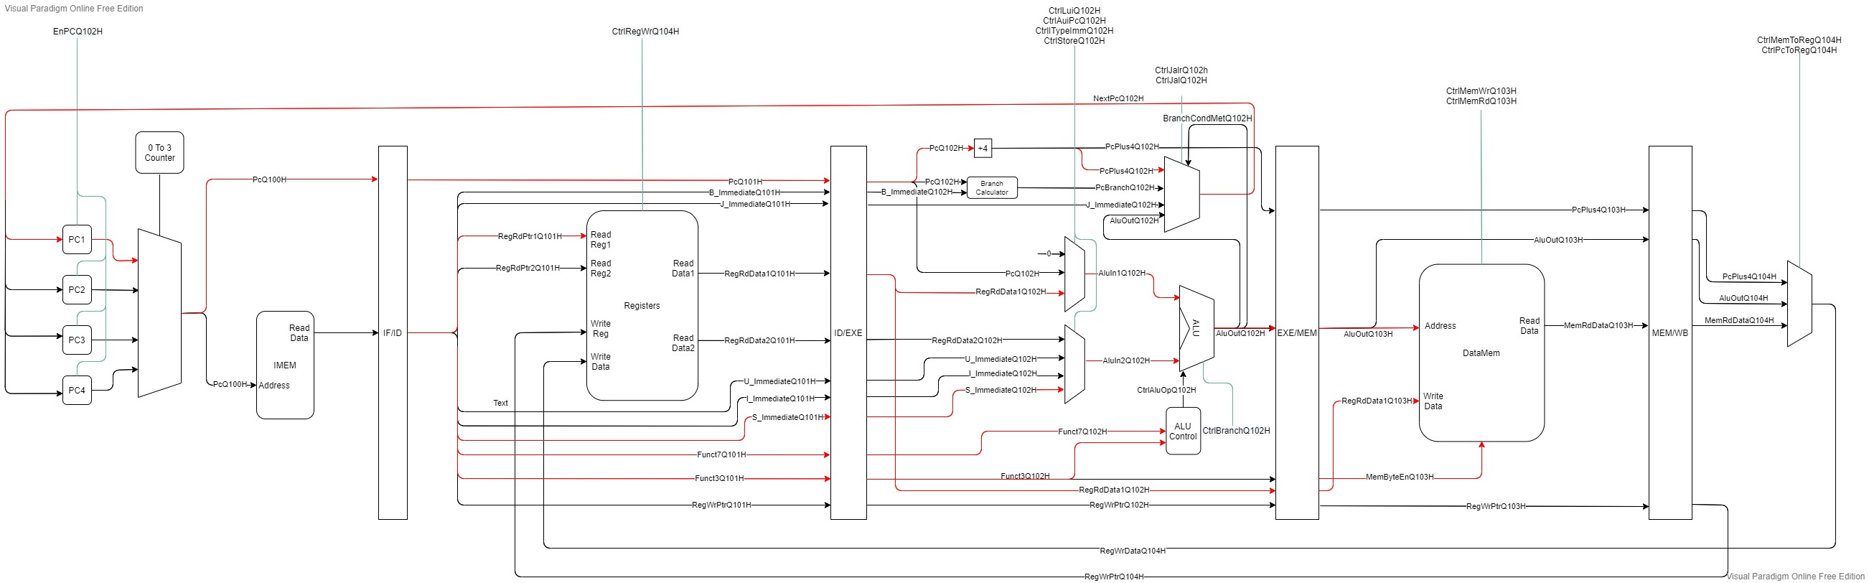
[picture p179: figure]

## Load

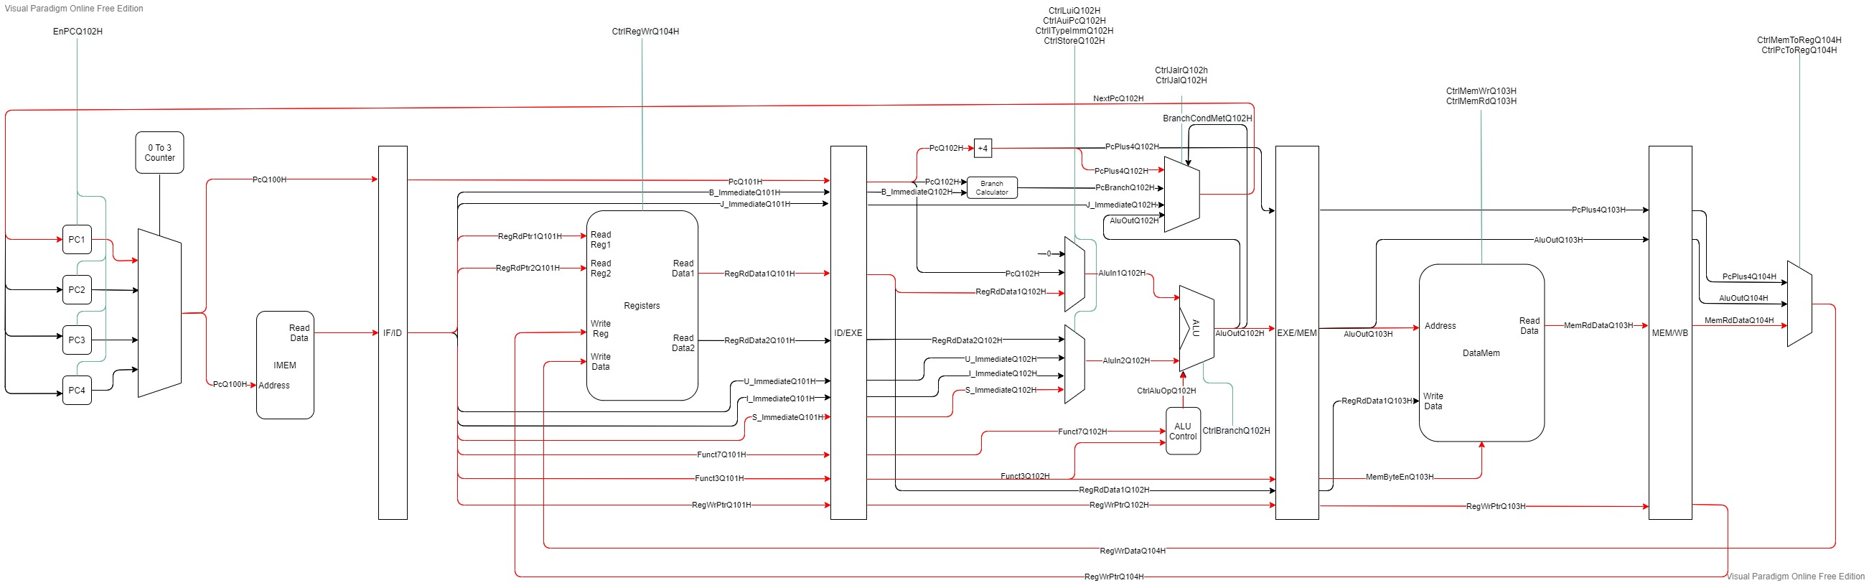
[picture p180: figure]
