amichai-bd/riscv-multi-core-lotr/(threads)

Thread 22 (2021-04-25):

GPC_4T - break down the Instruction at Q102 and not Q101 - will save  many FF

amichai-bd, 2021-04-25:
Looking at the diagram (and the code) we can see that Many of the samples at 101->102 are just different bits of the Instruction.
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

We should sample the "raw" Instruction 101->102 and at 102 we will break down the bits into the relevant structures:
- Immediate B/J/U/I/S.
- RegWrPtr
- Funct7
- Funct3

This will save many redundant FF - and as far as I can tell won't affect the Tpd timing in Cycle 102.
Let me know what you guys think.

adlv888, 2021-04-27:
with this implementation the decode stage will spread on 2 pipe stages 101 102 and can be little confusing. I personally prefer order but I will consult with Saar.

adlv888, 2021-05-05:
accept both ABD and SK opinion. Done

Closed 2021-05-05.

Thread 24 (2021-04-27):

GPC_4T - program a "_start/_init" in riscv assembly that calls the "main"

amichai-bd, 2021-04-27:
Currently, we have hacked our RTL code to resets the register file with the "correct" values.
('0 for all + Stack pointer and frame initialization)

We need an assembly program to link before our "main"

1) reset all 16 registers
2) loads the stack pointer correct value
3) jumps to the "main"

adlv888, 2021-05-10:
believe i did it. linker script cleans pipe with nop + reset 16 registers + load sp + jumps to main. i dont think it has irrelevant stuff

Thread 38 (2021-05-13):

Redefine memory layout in a future-compatible way

DL8, 2021-05-13:
Memory address space should be defined such that region and CORE_ID will be in the MSBs. This definition fits all possible memory sizes without the need to redefine and it is easier for software to work with a contiguous memory space.

Possible structure:
```
31:30 (region) | 29:22 (CORE_ID) | 21:0 (memory offset) |
````

Notes:
1. The order between region doesn't have to be as described (e.g. replacing between region and CORE_ID is acceptable)
2. The number of bits in CORE_ID should be discussed (balance between number of cores and possible amount of memory)
3. This proposed layout assumes I and D memories are of equal size and are a power-of-2. Removing this requirement may slightly complicate software interface

New CRs for software:
1. MEMORY_OFFSET_BITS - number of valid bits in the memory offset (e.g. 12 in case of I+D==4K)
2. CORE_ID_BITS - number of bits in CORE_ID (can be hardcoded in current releases)

amichai-bd, 2021-05-14:
Are there "standard" addresses that are reserved for that we should take into consideration?
For example the global variables?
Are there standard reserved memory spaces we should try to avoid?

using the MSB [31:30]  might be ok - but I'm not sure if it has other effects and impacts I'm not aware of.
Maybe we should keep them reserve and move the "region" bits down to [21:20]?

DL8, 2021-05-14:
Not really: the hardware should provide the memory space and it's up to software to partition it.

Regarding bits [31:30], I think it's better to use them if there are no problems and not waste precious address bits. One concern I can think of is how it will work with 64 bits, but that's far away.

Regarding the actual layout, it may be better to put CORE_ID in the MSBs because it's more intuitive, but on the other hand it may be more difficult to extend when we add more cores.

amichai-bd, 2021-05-14:
This makes me think maybe we should return to the original Address core location.
## This is my rationale:
1) the "local memory" that is located physically next to the core (direct access without ring, "0" latency)
2) having "local offset" bits [13:0]  + [15:14] region  is the maximum expected "on-die" local memory for each core.  15/16 bits D_MEM+I_MEM -> aka 64 KB of memory. that is the maximum I can imagine we may have. (in many-core architecture  this may be close to 2-8KB)
3) This way when we want to add more memory space - it won't be the cores "local memory" it will be a "shared" bigger memory on the Fabric (similar to Cache L3 -> but there is no HW cache-control - its all done using SW)
4) having the bits [23:16] as core ID and bits [31:24] as Reserved will allow us to add more cores in the future (more than 256) and allocate as much "non-local memory" (on-die like cache L3 or even external DDR memory)

Having the core/CR region bits in the MSB - will make a lot of memory interleave which in my opinion will be confusing.

DL8, 2021-05-15:
If we want to add more cores, a layout like this is what I have in mind:
`REGION [31:30] | CORE_ID [29:29-C+1] | reserved | memory offset [M:0] |`
Where:
* `C` - number of bits in CORE_ID (currently 8 => 29:22)
* `M` - number of bits in memory offset
`M` and `C` should be exposed to software via CR. They may be hardwired, of course.

Regarding shared memory, we have two bits of region but only 3 are occupied. Perhaps we can take the reserved region type and use it for shared memory access (let's call it `SHARED_MEM`). If I understand correctly, `CORE_ID` is irrelevant when we access shared memory, so we can use it as address offset bits to have a bigger address space:
`[31:30] == SHARED_MEM | TYPE [29] | reserved | shared memory offset [SH_M:0]`

`SH_M` is the number of bits in shared memory offset and should also be exposed via CR.

The `TYPE` bit is used to indicate whether it is memory or MMIO space. This is an optional addition if we want to have shared CR space.

amichai-bd, 2021-05-15:
This is what I had in mind:
(my origin proposal with some tweaks)
Each core has “continues” memory Space – very simple to take a core as an Embedded HW  and use it as is without spreading it to the entire memory space.
1) Having shared memory outside the core region can be distinguished with a bit higher from MSB. (similar to your latest proposal )
2) The “reserved” memory (bits [15:14]==10) may be the second layer of cores memory in the “fabric” – may be used as cores local memory but not within the cores “local-memory” in the “lotr_tile”. Accessing this memory will have a latency penalty (which we don’t have in the D_MEM region).
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

I see you as the SW expert – so if you think my layout is less scalable – and your latest suggestion makes more sense from the SW point of view – I’m willing to “fold” and agree with you.
But let's talk about it.

Thread 39 (2021-05-13):

GPC_4T - Add Interface of gpc_4t.sv

amichai-bd, 2021-05-13:
Please see the ring controller interface with the gpc_4 there:
https://github.com/amichai-bd/riscv-multi-core-lotr/wiki/HAS-RING_CTRL-RC

Please add the interface to the gpc_4t.sv as defined by RC HAS.

In the test bench gpc instance:
- input - strap to '0;
- output - leave dangling.

### Within the gpc_4t.sv - at this point no need to connect at all.
Eventually will be connected to :
1) D_MEM + I_MEM. (F2C ->Fabric to core)
2) Load/Store interface from core - in case the LW/SW request was not for the local memory (C2F -> Core to Fabric)

amichai-bd, 2021-05-13:
Please note - this task is important so others can start integrating the GPC_4T into the LOTR_TILE -> and to the Fabric LOTR.
@adlv888

adlv888, 2021-05-17:
done. hope its fine

amichai-bd, 2021-05-17:
I will try to integrate the GPC and the RC and I will let you know.

Closed 2021-05-24.

Thread 61 (2021-06-01):

GPC_4T - Heap enabling

adlv888, 2021-06-01:
how to generate the Systemverilog heap data so we can "load" it with the test

DL8, 2021-06-09:
I think the linker script should create a data segment, such that the data section will be in D_MEM. I don't know how to distinguish between global and local data with this approach though.

Yesterday in the library I added compilation-defined memory layout and the next step is to make it create a linker script that initializes memory according to the memory layout (e.g. place global variables in global data and in the future local data in local data sections)

adlv888, 2021-08-17:
after discussion , 2 issues regarding this:
1. the "HEAP" is  defined in this address:
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
all 4 threads takes data from this address which belong to certain thread and copy to seperate registers which is little wierd:
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
in this there is a 10 sized array.

2.bigger issue is with bigger arrays. in a 20 sized array the assembly code uses "memcpy" function which doesn't work and d_mem is empty besides the heap:
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

adlv888, 2021-08-17:
correction for 2 - it works and write to memory but after few cycles it overwrite the data with "xxxxxxxx"

adlv888, 2021-08-17:
we want the "HEAP" to be on shared mem?

amichai-bd, 2021-08-17:
I think we want this region of memory to be loaded to a shared dedicated area - should not be reliteive to the Stack Pointer offset.
All threads can access this area and modify this data independently - In SW you need to make sure they use this data in a coherent way - so they won't override each others modifications.

amichai-bd, 2021-08-17:
I agree we might have a problem here - if each thread will allocate parts of this area independently they might override each other.
We should talk about what's going on in the data_mem allocation when you set arrays within the "Main" vs in the specific thread.

adlv888, 2021-08-24:
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
Heap worked with a lot of data. closing issue

Closed 2021-08-24.

Thread 85 (2021-06-17):

Thread synchronization at reset is required for proper initialization

DL8, 2021-06-17:
Currently the library can't initialize memory layout, because all threads start up and there is no way to synchronize them: only one thread should perform initialization, but since memory is not initialized, it's not possible to establish a communication channel between threads (it should be done by a single thread). To address this, several approaches can be taken:
1. Hardware approach: change reset flow such that only one thread will start running. Software will be responsible to initialize what's needed and start other threads. This may be more complicated from hardware perspective, but will be easier to work with
2. Software approach: currently apps using the library are built with a text section (code) and data section (including GPC params, which will be loaded into global data in D_MEM). This will solve the problem on first launch, but will break on reset

### Discussed in https://github.com/amichai-bd/riscv-multi-core-lotr/discussions/52

amichai-bd, 2021-06-22:
We will add a couple of registers in the CR Space (which are deterministic at Reset) that will be used for general use for SW.
GPF (general purpose flag) - single bit indication
GPSP (general purpose scratchpad)

DL8, 2021-06-22:
Simplifying the definition for starter: 4 registers, each is 32 bits and reset value is zero. For naming, let's call them scratchpads (`SCRATCHPAD<i>` for `i=0,...,3`). I'll add that to the wiki.

As for other definitions (e.g. non-zero reset value, GPF), they may be useful in the future, but at the moment I don't see any use case for them. Also, I feel adding them makes the interface more complicated, because software will have to match hardware-enforced structure and hardware will need to define behavior in case of setting invalid values

DL8, 2021-06-23:
Library is updated to use scratchpad registers as documented in the wiki

Closed 2021-06-23.

Thread 87 (2021-06-18):

GPC_4T - Division Test

adlv888, 2021-06-18:
Division operation that is not between integers that are power of two, seem to not work
need to debug it

adlv888, 2021-06-27:
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
ARGGGGGHHHHHH!~!~!!!!!! Nailed it

amichai-bd, 2021-07-06:
Fixed

Closed 2021-07-06.

Thread 98 (2021-06-22):

Delegate parts of entry point code to C code

DL8, 2021-06-22:
Currently the entire entry point flow is implemented in a single Assembly file, which might be cumbersome and not portable with other architectures (e.g. in case M extension is supported). Once the stack is initialized, it may be possible to "delegate" parts of the entry point flow to utility functions written in C, which will be more portable and easier to maintain.

GPC global data initialization is a good starter, but other parts may be possible

Closed 2022-06-08.

Thread 125 (2021-07-07):

Remove data section from SV file

DL8, 2021-07-07:
Global data section should be initialized by the library code, because D_MEM doesn't survive reset. Also, it breaks loading the memory image into the testbench

DL8, 2021-07-07:
Global data should be initialized as part of entry point flow (how? Zeroes? Put data in I_MEM?)

Closed 2022-06-08.

Thread 153 (2021-10-13):

GPC_4t - add connectivity for writes - C2F to enable multi core test

amichai-bd, 2021-10-13:
currently missing the logic = should come from the D_MEM_WRAP

amichai-bd, 2021-11-17:
This was implemented by @adlv888

Closed 2021-11-17.

Thread 161 (2021-12-04):

GPC_4T - The Documentation

amichai-bd, 2021-12-04:
Please make 5 Word files:
1) GPC_4T project.docx (eventually will contain the other 4 documents)
2) GPC_4T HAS.docx
3) GPC_4T MAS.docx
4) GPC_4T Validation Plan.docx
5) GPC_4T Development & Methodologies.docx

### 1) GPC_4T project.docx
*prefix - of the Finals Document*
- About the Project
- About the authors
- Structure of the document
  - High-Level-Specifications (HAS)
  - Micro-Architecture-Specifications (MAS)
  - Validation Plan
  - Development Environment and Methodologies

### 2) GPC_4T HAS.docx
*HAS - Make sure this is simple, short, and in high level*
- General Description
  - High Level Definition
  - RISCV & ISA
  - CPU (HW arch)
    - HW Multi Threading
  - GPC_4T within the LOTR project
- Block diagram
- Top Level & Block Interface
- Design Building Blocks
  - Core & Pipe Stages
  - Memory Regions
    - I_MEM
    - D_MEM
    - CR_MEM
- Supported features
    - CR table & functionality
    - Writing to Non Local Memory.
    - Reading from Non Local Memory

### 3) GPC_4T MAS.docx
*MAS - Here is where the diagrams and detail should be*
- General Description
  - High Level Definition
  - Block diagram
  - Top Level & Block Interface
- Design Building Blocks
  - Core & Pipe Stages
    - Detailed Core Block diagram
    - Fetch
    - Decode
    - Excecute
    - Memory Access
    - Write Back
  - I_MEM
  - D_MEM
  - CR_MEM
- Design Flows
  - Thread Freeze using CRs.
  - Thread Rst using CRs.
  - Multi Thread Example. (Single 4 Thread Core)
  - Writing to Non Local Memory.
  - Reading from Non Local Memory

### 4) GPC_4T Validation Plan.docx
*Validation Plan*
- Introduction
- GCC RISCV Compiler & programs
  - GCC to generate tests
  - GPC_4T Feature coverage
    - ISA Coverage - RV32I
    - Alive test
    - CRs features & Dedicated tests
    - Multi Thread application
    - Automation & Scripts (gpc_compile_link.sh)
- System Verilog Test Bench
  - Test Bench (gpc_4t_tb.sv)
  - Log generator
  - End Of Test Snapshot Checker
  - Assertions
  - RTL complication (list.f)
  - Load Backdoor I_MEM
  - Simulation
  - Automation & Scripts (tb_sim.ps1)

### 5) GPC_4T Development & Methodologies.docx
*Development Environment and Methodologies*
  - Git & GitHub
    - Git
    - GitHub
  - Repository structure
  - RISCV GNU Compiler Tool-Chain
    - GCC
    - WSL (mention that there are alternatives)
  - System Verilog
    - Project Coding Style (Macros, Cycle suffix)
  - Modelsim
  - PowerShell & Bash

amichai-bd, 2021-12-04:
@adlv888 @SaarKadosh

Closed 2022-01-03.

Thread 164 (2022-01-06):

LOTR - Replace the std interface of ThreadID (2 bit) with requestor (10 bit)

amichai-bd, 2022-01-06:
To keep the STD interface alighn we will use the 10 bit.
This will cancel out the optimization of using only 2 bits - but its good for the long run STD.

Thread 166 (2022-01-08):

LOTR - Add Tracker file for a single RC

amichai-bd, 2022-01-08:
To ease debugging, Please make a tracker for each RC:
single file for each RC.
should track all 8 Interfaces!! (Channel, Opcode, Address, Requestor, Data)
1. RingReqIn
2. RingRspIn
3. RingReqOut
4. RingRspOut
5. C2F_Req
6. C2F_Rsp
7. F2C_Req
8. F2C_Rsp

adlv888, 2022-04-07:
ok so this one i did

amichai-bd, 2022-05-01:
@adlv888 - reminder, Please send a screenshot here & close this issue.

adlv888, 2022-05-01:
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

adlv888, 2022-05-01:
not closing yet, adding some fixes we talked about (like ---- on read "requested data")

adlv888, 2022-05-21:
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

Closed 2022-05-21.

Thread 170 (2022-03-03):

LOTR - Enable Stall

adlv888, 2022-03-03:

adlv888, 2022-05-01:
@amichaibd can you please write a brief explain about this issue?

amichai-bd, 2022-05-01:
currently, nothing is stopping the core to send as many requests to the ring.
This is a problem - what if the C2F is full and the core wants to send another write request?
This si why we need a "stall" to make sure the core will not send request when the C2F buffer is already full

amichai-bd, 2023-01-21:
Still a issue.
As long the RING is not very traffic-loaded, things are working for now.
But this should be fixed!

Thread 172 (2022-04-07):

LOTR - RC debug

adlv888, 2022-04-07:
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
seems that RC is having some issues with transactions
need to debug

adlv888, 2022-05-01:
found the issue with the READ. ridiculous and amazing issue :
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

"d_mem" had no signal called "pre_q_b". only the assign with no declaration. I added this declaration and it fixed(Line 39):
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

 how is this possible ? how it was compiled until now ? WTF?!

amichai-bd, 2022-05-01:
We should start running more advanced "Static checks" that make sure we dont have this kind of issue again.
A good option is to use the "quartos compiler" - this will notify us in case we have any other similar violations.

Closed 2022-05-01.

Thread 177 (2022-06-08):

LOTR - Redundant Signals toggle on ring transactons

adlv888, 2022-06-08:
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

adlv888, 2022-06-08:
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
fix : wrong signals wiring
ABD resolved

Closed 2022-06-08.

Thread 187 (2022-06-12):

LOTR - make sure the D_MEM & I_MEM can run also when configured as 8

amichai-bd, 2022-06-12:
- set linker
- set RTL param package
- set FPGA memory arrays

We should figure out how to get the build set everything correctly with a single switch.
The default should be 16kb for the D/I memories.

amichai-bd, 2022-08-18:
We cant simply configure.
We moved to 8KB memory.

Closed 2022-08-18.

Thread 192 (2022-06-27):

LOTR - arrange repository files and c programs

adlv888, 2022-06-27:

amichai-bd, 2022-07-06:
see also this issue:
"LOTR - set defines.h file for volatile int addresses" #188

amichai-bd, 2022-07-28:
Make sure the defince include ALL the CRS, arduino, VGA, spaces for easy access in C.

Closed 2022-08-06.

Thread 193 (2022-06-27):

LOTR.inc- Enable UART Tile phase 1

amichai-bd, 2022-06-27:
## Phase 1:
- Create UART Tile (instantiate an RC module in it)
- Add a Shift register to accept all the UART Transaction
- Design a State machine to consume the Register & packet it to an RC transaction.

ChrisShakkour, 2022-08-03:
initial UART rtl design IP committed, to develop a uart State machine for configuring and managing the gateway between the ring interface and the outer Uart Host.

ChrisShakkour, 2022-11-19:
Tile created. on STUB design (Black box)

ChrisShakkour, 2022-12-06:
Resolved - migrated to other small tasks.

Closed 2022-12-06.

Thread 194 (2022-06-27):

LOTR.inc - Integrate SCR RISCV synta Core

amichai-bd, 2022-06-27:
- connect to the UART
- allows Memory transaction to the Ring -> Read & write.
-  Split the memory to "i_MEM" & "D_MEM"

amichai-bd, 2022-10-18:
Pivoted from this idea.
Close wont fix

Closed 2022-10-18.

Thread 195 (2022-06-28):

LOTR - The Documentation

adlv888, 2022-06-28:

amichai-bd, 2022-07-28:
מבחינת דוקומנטציה, אני לא מחפש משהו ארוך במיוחד. אלו הנקודות העיקריות:
1) הסבר על VA vs PA (זיכרון פיסיקלי לעומת וורטואלי) ברמת הcore וברמת הSOC.
2) הסבר על הRING והTILE
3) הסבר על הVGA  החומרה והפרוטוקול.
4) הסבר על הDE10Lite
5) הסבר על הCR החדשים של הDE10LIte.
6) הפרמטרים האפשריים של הפרוייקט (מספר cores וגודל זכרונות)
7) דוגמאות קוד לsingle threads, 4 THreads ו8 THreads.87 + ספריות תוכנה בסיסיות + צילומי מסך ופלטים.
8) עולם הוולאדיציה והוורפיקציה של התוכנה + חומרה + FPGA + סימוציה
9) פרק קצר על כלים, סקריפטים, גיט, סביבה פיתוח וכו.

Closed 2022-10-18.

Thread 196 (2022-06-29):

LOTR - bug in rc

adlv888, 2022-06-29:
some instructions not works if redundant lines are **not** written (lines 72 73)
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

amichai-bd, 2023-01-21:
Strange..
But currently things are working.
Might reopen in future

Closed 2023-01-21.

Thread 201 (2022-07-09):

LOTR - make a 4 thread test with VGA feedback

amichai-bd, 2022-07-09:
To avoid problems in the ring. Make a test with a single-core - 4 threads.

Split the Display to 4 squares. Each will be written from a different thread.

Rectangles are generated by writing 0xFFFFFFFF to a specific VGA address offset.
1) counter - represented by a number of rectangles.
2) rotating rectangle around the perimeter
3) simple patterns switching (checkers, lines, etc.)
4) spell hello using rectangles

amichai-bd, 2022-07-28:
Please program this:
https://www.youtube.com/watch?v=ZZuD6iUe3Pc

adlv888, 2022-08-06:
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

amichai-bd, 2022-08-18:
The example you made looks great!
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

But I think it's still missing a header per thread:
- "Thread 0 - Bubble Sort"
- "Thread 1 - Quick Sort"
- etc.

Closed 2022-10-18.

Thread 202 (2022-07-16):

LOTR - bug in the "char *" types , GPC_4T core is not working as expected with Char * type

amichai-bd, 2022-07-16:
When trying to enable the printf() in the LOTR, found an error in how LOTR manipulates the char data types.

We must make a dedicated test for the char type and char* to manipulate char arrays.

This is very important  for the VGA and to finish the LOTR project!

amichai-bd, 2022-07-16:
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

i think this is the problem. currently, we are not supporting the instructions LBU, LHU

amichai-bd, 2022-07-16:
Maybe the problem is the "linker" - I see in the simulation access to a non-4byte align memory.
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

amichai-bd, 2022-07-16:
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

amichai-bd, 2022-07-28:
Probebly wont get to fix this in this project - Please make sure you use only INT (not char)

amichai-bd, 2022-08-18:
@adlv888 @SaarKadosh
I fixed this - that's what allowed us to use the "printf"

Closed 2022-08-18.

Thread 203 (2022-07-18):

LOTR - Add a "+define+MEM_SIZE=KB8" to change the size of I_MEM & D_MEM from 4KiB to 8KiB

amichai-bd, 2022-07-18:
- Make sure the Memory Space splits the Data Section correctly between the Threads.
  - The +define should affect the values of the offsets
  - The current offsets:
    > • 0x00400200 - 0x00400000 Thread0 Region. 512B
    > • 0x00400400 - 0x00400200 Thread1 Region. 512B
    > • 0x00400600 - 0x00400400 Thread2 Region. 512B
    > • 0x00400800 - 0x00400600 Thread3 Region. 512B
    > • 0x00400FFF - 0x00400800 Shared Mem Region. 2KB
- Design a compatible 16kb Memory for FPGA, with loadable D_MEM/I_MEM files.

<!-- Edit the body of your new issue then click the ✓ "Create Issue" button in the top right of the editor. The first line will be the issue title. Assignees and Labels follow after a blank line. Leave an empty line before beginning the body of the issue. -->

amichai-bd, 2022-07-28:
1) affecting the linker
2) affecting the CR
3) affecting the FPGA RAM moduls
4) affecting the Parameters in the Common Sytemverilog files

amichai-bd, 2022-08-18:
We moved to 8K.
But not easy to switch back to 4K.
So closing as "wont fix"

Closed 2022-08-18.

Thread 204 (2022-07-18):

Add a "+define+MEM_SIZE=KB16" to change the size of I_MEM & D_MEM from 4KiB to 16KiB

amichai-bd, 2022-07-18:
- Make sure the Memory Space splits the Data Section correctly between the Threads.
  - The +define should affect the values of the offsets
  - The current offsets:
    > • 0x00400200 - 0x00400000 Thread0 Region. 512B
    > • 0x00400400 - 0x00400200 Thread1 Region. 512B
    > • 0x00400600 - 0x00400400 Thread2 Region. 512B
    > • 0x00400800 - 0x00400600 Thread3 Region. 512B
    > • 0x00400FFF - 0x00400800 Shared Mem Region. 2KB
- Design a compatible 16kb Memory for FPGA, with loadable D_MEM/I_MEM files.

<!-- Edit the body of your new issue then click the ✓ "Create Issue" button in the top right of the editor. The first line will be the issue title. Assignees and Labels follow after a blank line. Leave an empty line before beginning the body of the issue. -->

amichai-bd, 2022-07-18:
test

Closed 2022-07-18.

Thread 206 (2022-07-18):

LOTR - Make the ascii lookup table part of the D_MEM. (the GCC should load it to D_MEM)

amichai-bd, 2022-07-18:
Make the ascii lookup table part of the D_MEM. (the GCC should load it to D_MEM)
Currently in the Alive_VGA_3 test the Table is loaded from SW using te function "set_table()".

<!-- Edit the body of your new issue then click the ✓ "Create Issue" button in the top right of the editor. The first line will be the issue title. Assignees and Labels follow after a blank line. Leave an empty line before beginning the body of the issue. -->

amichai-bd, 2022-08-18:
DONE.
Simply include the graphic.h file to the program.
https://github.com/amichai-bd/riscv-multi-core-lotr/blob/master/apps/scripts/gpc_compile_link/graphic.h

Closed 2022-08-18.

Thread 207 (2022-07-21):

LOTR + GPC_4T - add a "stack overflow error"

amichai-bd, 2022-07-21:
Please add logic to ensure all the stack pointers of each thread do not overflow to the memory region of the next thread or outside the memory stack. (which can occur when having too many nested functions like in recursive programs)

The logic will set the CR, which indicates an error - and should freeze the core (the EN_PC CR).
Also - this CR should be exposed to a visual representation on the FPGA. (7SEG / LED)
Simple "or" the LED/7SEG CRs with the Core CR that has the error.

amichai-bd, 2022-07-21:
+ add an assertion for simulation.

We should probably connect all the "assertions" to this error indication.

amichai-bd, 2023-01-21:
Nice to have. But not planned for this project.
maybe in this project:
https://github.com/amichai-bd/riscv_manycore_mesh_fpga

Closed 2023-01-21.

Thread 220 (2022-08-18):

LOTR - make a 8  thread: 2 types of sorting, 4 Data Sets.

amichai-bd, 2022-08-18:
https://www.toptal.com/developers/sorting-algorithms
**2 Algorithm**
- Bubble Sort
- insertionSort / quickSortIterative / mergeSort
**4 Data Sets:**
- random
- few unique
- reversed
- almost sorted

8 in total Threads. (4x2)

adlv888, 2022-09-05:
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

clockwise from top left : random, reverse, few unique, almost sorted.

insertion above bubble

Closed 2022-09-05.

Thread 224 (2022-09-07):

LOTR - Make menu to start different applications

amichai-bd, 2022-09-07:
Menu - Home Page, After reset start here

display a menu with 3 options
1. HW system information
2. Simple Proof of concept, 8 thread applications
3. Simple Game / other small function such as animation
4. FPGA LED & 7 seg light show

Explain in header that to choose an option need to set the "switch" to a binary value, and press the Button

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

Closed 2022-10-18.

Thread 225 (2022-09-07):

LOTR - Change the functional Reset to SW[9] && Botton_1

amichai-bd, 2022-09-07:

amichai-bd, 2023-01-21:
This will allow us to use the two buttons for other usages instead of just reset.

Thread 226 (2022-09-07):

LOTR - create a simple Snake game

amichai-bd, 2022-09-07:
Use my reference of "snake"
Make sure you understand existing architecture and what are the changes you need:
1. change the size of objects & arrays (don't use the int, use short/char)
2. Make the Button sample "sticky" using the delay function to sample the Button and keep the latest value.
3. Include the graphic lib and write information to display
4. make a smaller "plain" for snake to move around. (smaller "box" boundary)

Closed 2022-10-18.

Thread 235 (2022-11-19):

UART - Design task - to design the gateway FSM

ChrisShakkour, 2022-11-19:
this FSM will be responsible for commanding all units in the gateway module to create a valid workflow and create backpressure, and handle errors when occuring.

ChrisShakkour, 2022-12-24:
Resolved - back pressure handled internally in the transfer handler engine.

Closed 2022-12-24.

Thread 237 (2022-11-19):

UART - Documentation task - To write uart tile Arch spec 0.8

ChrisShakkour, 2022-11-19:

ChrisShakkour, 2023-01-07:
Resolved - Done

Closed 2023-01-07.

Thread 240 (2022-11-19):

UART - System Level  task - To enable user write burst transfers from file on Host device

ChrisShakkour, 2022-11-19:

ChrisShakkour, 2022-12-10:
Resolved - Done

Closed 2022-12-10.

Thread 241 (2022-11-19):

UART - System Level  task - To enable user read burst transfers to a file on Host device

ChrisShakkour, 2022-11-19:

ChrisShakkour, 2023-01-08:
Resolved - done

Closed 2023-01-08.

Thread 242 (2022-11-19):

UART - Design task - uart config flow via wishbone invalid

ChrisShakkour, 2022-11-19:
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

Need to add at least one cycle delay on the wishbone after acknowledge signal is asserted before sending the next read/write request. writes are not being written due to this violation.

a HOTFIX will be sampling the ack signal and feeding the FSM with the sampled ACK so you don't have to add dummy states on the state machine... in short, words delaying in one cycle the condition that moves on to the next state in the FSM...

something like this:
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

Thread 248 (2022-12-06):

UART - design task - timeout counters safety twards the RC if a write/read request is not served

ChrisShakkour, 2022-12-06:

ChrisShakkour, 2023-01-06:
Resolved - done

Closed 2023-01-06.

Thread 249 (2022-12-06):

UART - Documentation task - transfer handler engine FSM and IO spec

ChrisShakkour, 2022-12-06:

ChrisShakkour, 2023-01-19:
Resolved - Done

Closed 2023-01-19.

Thread 250 (2022-12-06):

UART - Verification task - make sure the RC integration is successful.

ChrisShakkour, 2022-12-06:
to run a simple test on the FPGA to make sure the Ring is not broken. need to strap the C2F interface to Zero or drive logic.

ChrisShakkour, 2022-12-12:
tested on Alive_VGA_3 test saw the RC transaction bypass the UART Tile...

Closed 2022-12-12.

Thread 252 (2022-12-10):

UART - Performance boost - to calibrate uart baud rate to higher bitrates than current 9600

ChrisShakkour, 2022-12-10:
following possible baud rates: 14400, 19200, 38400, 57600, 115200, 128000
this is dependent on the signal integrity between the Host and Device and RC performance/latency due to back pressure.

ChrisShakkour, 2022-12-24:
Resolved - Done, set to 115200 bits per sec

Closed 2022-12-24.

Thread 255 (2022-12-11):

UART - FPGA integration - to synthesise Transfer handler engine and clean latches.

ChrisShakkour, 2022-12-11:

ChrisShakkour, 2022-12-21:
Resolved

Closed 2022-12-21.

Thread 256 (2022-12-11):

UART - Design task - to enable write transfer on new interface

ChrisShakkour, 2022-12-11:

ChrisShakkour, 2022-12-24:
Resolved - Done

Closed 2022-12-24.

Thread 257 (2022-12-11):

UART - Design task - To respond to the Uart side with Acknowledge after read/write...

ChrisShakkour, 2022-12-11:

ChrisShakkour, 2023-01-06:
Resolved - done

Closed 2023-01-06.

Thread 264 (2023-01-09):

UART - POC task(last issue)

ChrisShakkour, 2023-01-09:
to run multiple test on VGA.

amichai-bd, 2023-01-11:
see #265.
it has the sv memory for the test

Closed 2023-01-20.

Thread 265 (2023-01-09):

UART - POC task - To create sv files for multiple tests

ChrisShakkour, 2023-01-09:
to test the UART tile functionality and application.

amichai-bd, 2023-01-11:
See SV for testing here:
https://github.com/amichai-bd/riscv-multi-core-lotr/tree/master/verif/Tests/super_sorting_VGA
https://github.com/amichai-bd/riscv-multi-core-lotr/tree/master/verif/Tests/led_blinky
https://github.com/amichai-bd/riscv-multi-core-lotr/tree/master/verif/Tests/fpga_main

1. Make sure to add offset -> write to every Core
3. make sure to rest PC and free the rest
4. Connect VGA to see results
5. READ the C file of each test to understand what expected behavior

@ChrisShakkour  - let me know if you need anything else here.
closing this issue - please re-open if you need anything else

Closed 2023-01-11.

Thread 266 (2023-01-11):

UART - System-level task - to add offset address for write burst transfers

ChrisShakkour, 2023-01-11:

ChrisShakkour, 2023-01-11:
Resolved - Done

Closed 2023-01-11.

Thread 270 (2023-01-19):

UART - add option to load sequence of instruction to the python

amichai-bd, 2023-01-19:
Here are a couple of examples of files sequences:
core1_freeze.txt:
```
W  ,  0x01C00150  ,  0x0
W  ,  0x01C00154  ,  0x0
W  ,  0x01C00158  ,  0x0
W  ,  0x01C0015C  ,  0x0
```
core1_realease.txt:
```
W  ,  0x01C00150  ,  0x1
W  ,  0x01C00154  ,  0x1
W  ,  0x01C00158  ,  0x1
W  ,  0x01C0015C  ,  0x1
```

load_fpga_main_program.txt:
```
//===CORE 1&2 freeze PC0,PC1,PC2,PC3====
`include core1_freeze.txt  // if we can support this, it will improve things
`include core2_freeze.txt  // we can explicitly write the freeze instead if `include

//===CORE 1 load instruction & data====
WB ,  0x01000000  ,  ../../../../verif/Tests/fpga_main/fpga_main_inst_mem_rv32i.sv
WB ,  0x01400000  ,  ../../../../verif/Tests/fpga_main/fpga_main_data_mem_rv32i.sv

//===CORE 1 load instruction & data====
WB ,  0x02000000  ,  ../../../../verif/Tests/fpga_main/fpga_main_inst_mem_rv32i.sv
WB ,  0x02400000  ,  ../../../../verif/Tests/fpga_main/fpga_main_data_mem_rv32i.sv

//===CORE 1&2 reset PC0,PC1,PC2,PC3====
W  ,  0x01C00100  ,  0x1
W  ,  0x01C00104  ,  0x1
W  ,  0x01C00108  ,  0x1
W  ,  0x01C0010C  ,  0x1
W  ,  0x02C00100  ,  0x1
W  ,  0x02C00104  ,  0x1
W  ,  0x02C00108  ,  0x1
W  ,  0x02C0010C  ,  0x1

//===CORE 1&2 release reset PC0,PC1,PC2,PC3====
W  ,  0x01C00100  ,  0x0
W  ,  0x01C00104  ,  0x0
W  ,  0x01C00108  ,  0x0
W  ,  0x01C0010C  ,  0x0
W  ,  0x02C00100  ,  0x0
W  ,  0x02C00104  ,  0x0
W  ,  0x02C00108  ,  0x0
W  ,  0x02C0010C  ,  0x0

//===CORE 1&2 Enalbe PC0,PC1,PC2,PC3====
W  ,  0x01C00150  ,  0x1
W  ,  0x01C00154  ,  0x1
W  ,  0x01C00158  ,  0x1
W  ,  0x01C0015C  ,  0x1
W  ,  0x02C00150  ,  0x1
W  ,  0x02C00154  ,  0x1
W  ,  0x02C00158  ,  0x1
W  ,  0x02C0015C  ,  0x1
```

ChrisShakkour, 2023-01-20:
@amichai-bd closing this task, i think the input pipe < using Linux features does a great job. do you agree?

amichai-bd, 2023-01-21:
Almost =)
You should write at least one sequence yourself to make sure you get the hang of it and you will be able to present it to others (and Goel).
I recommend a sequence that restarts any program that is already loaded.
1. Reset the "ALL_PC_RESET"
2. set all the PC enable one by one. (in our case, 8 writes)
3. Release the "ALL_PC_RESET"

The sequence should solve the problem of the Program not restarting without hard reset.
The programs that ended the sorting disabled their own PC - so just resetting the PC without enabling it wont work
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

Please make sure you create it, run it, and send a video - then you can close this issue.

Note:
This is a very small task that you probably need to do anyways before your live presentation

amichai-bd, 2023-01-21:
Here is the sequence you need:
1. reset the "CR_ALL_PC_RESET"       0x3C02040 (`1` will reset) //affects all cores
1. enable the CR_THREAD0_PC_EN  0x1C00150 (`1` will enable)//core 1
1. enable the CR_THREAD1_PC_EN  0x1C00154 (`1` will enable)//core 1
1. enable the CR_THREAD2_PC_EN  0x1C00158 (`1` will enable)//core 1
1. enable the CR_THREAD3_PC_EN  0x1C0015c (`1` will enable)//core 1
1. enable the CR_THREAD0_PC_EN  0x2C00150 (`1` will enable)//core 2
1. enable the CR_THREAD1_PC_EN  0x2C00154 (`1` will enable)//core 2
1. enable the CR_THREAD2_PC_EN  0x2C00158 (`1` will enable)//core 2
1. enable the CR_THREAD3_PC_EN  0x2C0015c (`1` will enable)//core 2
1. release the "CR_ALL_PC_RESET"   0x3C02040 (`0` will reset)//affects all cores

sequence/restart_prgram.txt
```
COM3
W
0x3C02040
0x1
W
0x1C00150
0x1
W
0x1C00154
0x1
W
0x1C00158
0x1
W
0x1C0015C
0x1
W
0x2C00150
0x1
W
0x2C00154
0x1
W
0x2C00158
0x1
W
0x2C0015C
0x1
W
0x3C02040
0x0
Q
Q
```

amichai-bd, 2023-01-21:
Please add an option to add "comments" to the sequence so that the uart_term.py won't reject as an error.
That will make it much easier to write/read sequences.
example:
```
COM3
// CR_ALL_PC_RESET = 1 - reset the program counters in the LOTR
W
0x3C02040
0x1
```

Thread 275 (2023-03-30):

LOTR - New POC

amichai-bd, 2023-03-30:
@adlv888
# First :
- install the builder env used for the LOTR
- RISCV GCC for windows
- Make sure the build works
- connect uart and make sure Uart works

# Second:
Let's set a time to meet and work on the new POC together.
Mainly SW design:
- 8-thread utilization
- UART communication - pre-thread freezing, resetting, etc..
- IO

Thread 277 (2023-06-11):

LOTR - DE120Lite_MMIO wrong F2C_RspValid expression

asapir, 2023-06-11:
In source/lotr/rtl/DE10Lite_MMIO.sv line 204:
assign F2C_RspValidQ504H = CtrlCRMemRdEnQ504 || CtrlCRMemWrEnQ504 || CtrlVgaMemRdEnQ504 || CtrlVgaMemWrEnQ504;

This expression set the valid response signal, the issue is the WrEn should not trigger response valid and should be removed form RHS

assign F2C_RspValidQ504H = CtrlCRMemRdEnQ504 || CtrlVgaMemRdEnQ504;

amichai-bd, 2023-06-11:
Great catch!
This should be fixed as well!

Did you try and run the LOTR on an FPGA or simulation?
How did you find these errors?

asapir, 2023-06-11:
I ran simulation. I did some changes to rc and lotr loggers, making the rc log file looks the same (same format) in both TB. Then write an ugly python code to parse it and report protocol issues.
________________________________
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

amichai-bd, 2023-06-11:
Thank you @asapir for your interest and contribution for this LOTR project!

I will note that this was a project I advised for over the 2-3 years and we got it up and working on FPGA!
But since the student that worked on it graduated, this is not getting much maintenance.

If you are interested in RISCV and would like to part of a really cool project that we are working on - please see the https://github.com/amichai-bd/fpga_mafia

Many things are similar, but we are trying to make the design more robust, less proprietary, more scalable and with a lot more features!

It is WIP, but in the next 2-3 months we should have a working FPGA!

asapir, 2023-06-12:
Hi Amichai,

This looks very interesting, I’ll take a look. There is something that you need?

Thanks, Asi
________________________________
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

amichai-bd, 2023-06-12:
We have an endless list of features we would like to support.
Some need involvement in many disciplines to get to work.
RTL design.
HW verification.
Post prosses automation checkers
RISCV SW stack, builder, linkers

Example:
Write POC programs that can utilize the many-core architecture (with a good foundation and reusability of the SW architecture)
Support other IO on FPGA. (joystick, keyboard)
Support RGB mode on the VGA display. (lower resolution but add RGB) -> need to define the exact HW-SW handshake.
Improve the build, automation, github "actions" workflow
Add GUI application to interact with the environment. (run tests, tests status)
Add Gui application to interact with the UART & FPGA (Host->device read/write to FPGA MMIO, readout mems, debug etc.)

And many more!

You let me know what you think you want to assist with and we can set concrete task that w can integrate to the design.

Let me know!
You are welcome to email me (abendavid@nvidia.com / amichaibd@gmail.com) and we can even set a meeting if you'd like.

Closed 2023-06-11.
