amichai-bd/riscv-multi-core-lotr/FPGA/adc/adc_qsys/synthesis/submodules/altera_up_avalon_adv_adc.v

// (C) 2001-2020 Intel Corporation. All rights reserved.
// Your use of Intel Corporation's design tools, logic functions and other 
// software and tools, and its AMPP partner logic functions, and any output 
// files from any of the foregoing (including device programming or simulation 
// files), and any associated documentation or information are expressly subject 
// to the terms and conditions of the Intel Program License Subscription 
// Agreement, Intel FPGA IP License Agreement, or other applicable 
// license agreement, including, without limitation, that your use is for the 
// sole purpose of programming logic devices manufactured by Intel and sold by 
// Intel or its authorized distributors.  Please refer to the applicable 
// agreement for further details.


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
//  - - - - - - - - - -ADC- - - - - - - - - - - - - - -
module altera_up_avalon_adv_adc (clock, reset, go, sclk, cs_n, din, dout, done, reading0, reading1, 
						reading2, reading3, reading4, reading5, reading6, reading7);
input go, dout, clock, reset;

output reg done;
output reg sclk, din, cs_n;
output reg [11:0] reading0, reading1, reading2, reading3, reading4, reading5, reading6, reading7;

parameter T_SCLK = 8'd4;
parameter NUM_CH = 4'd7;
parameter BOARD = "DE10-Standard";
parameter BOARD_REV = "Autodetect";
parameter MAX10_PLL_MULTIPLY_BY = 1;
parameter MAX10_PLL_DIVIDE_BY = 10;

generate

    if (BOARD == "DE10-Lite")
    begin
    
        parameter   resetState = 3'd0, idleState=3'd1, turnOnSequencerState=3'd2, pendingConversionState=3'd3, readConversionState=3'd4, doneConversionState=3'd5;
        reg [3:0]   channel;
        reg [2:0]   currState, nextState;
        wire        sample_store_irq; 
        wire [31:0] sample_store_readdata;
        reg         sample_store_read, sample_store_write;
        wire [31:0] sample_store_writedata;
        reg [6:0]   sample_store_address;
        reg         sequencer_write;
        wire [31:0] sequencer_writedata;
        reg         sequencer_on;
        wire        adc_pll_locked;
        wire        adc_pll_clk;
        
        // Constant outputs
        assign sequencer_writedata = 32'd1;
        assign sample_store_writedata = 32'd1;
        
        always @(*)begin
            {sclk, din, cs_n} <= 3'bzzz;
        end
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
