amichai-bd/riscv-multi-core-lotr/(commit log)

2021-04-13 Enable 4 threads PC. Desble thread [3:1] (keep only Thread[0])
2021-04-14 Fix backdoor i_mem force
    [gpc_4t_tb.sv]
2021-04-18 add initiate signals to sp and s0 and fix d_mem bug
    [core_4t.sv, d_mem_wrap.sv]
2021-04-24 Finally improved and arrenged the code according to MAS. The code is now orginized according to pipe stages and should support initial instructions. Not tested in simulation yet
2021-04-28 code fixed after ABD review + code compiled successfully
    [core_4t.sv, gpc_4t.sv]
2021-04-29 Make ascii hader before each pipestage. Enable all threads.
2021-05-10 core fix for jal cmd , alu ctl location,missing signals
    [core_4t.sv]
2021-05-10 jal fix + alu ctrl fix + missing signals + erase sp reset
    [core_4t.sv]
2021-05-11 modelsim README run compilation and simulation from command line POWER SHELL
2021-05-11 fix bugs on core with LW SW + artificially fix d mem
    [core_4t.sv, d_mem.sv]
2021-05-11 core bug fix issues on LW\SW + d_mem temp fix
    cant upload from git bash
    [core_4t.sv, d_mem.sv]
2021-05-17 create basic library
    * create entry point code based on existing one
    * create c headers for library
    * use 2 entry points approach: one setup and one loop
    * add test with empty implementation for both
    * create makefile
    * review build flags and ld script (no standard library is used now)
    * build toolchain applicable for arch linux (packages riscv64-elf-*)
    opens:
    * configurable memory offsets (e.g. I_MEM, D_MEM and MMIO base addresses)
    * current build with library is fragile. how to fix _start into address 0?
    * optimizations: which ones should be used?
    * WHOAMI CR offset and structure
2021-05-17 Initial fixing of the gpc_param_pkg.
    [core_4t.sv, d_mem.sv, d_mem_wrap.sv, gpc_4t.sv, gpc_4t_param_pkg.sv, i_mem.sv, i_mem_wrap.sv]
2021-05-19 LOTR Pitch and Visio
2021-05-19 Fix Alive test - Parameters, connectivity etc..
    [core_4t.sv, d_mem_wrap.sv, gpc_4t_param_pkg.sv, gpc_4t_tb.sv, i_mem.sv, i_mem_wrap.sv]
2021-05-19 Fix region offet Basic CR/SR access
    [core_4t.sv, d_mem_wrap.sv, gpc_4t_param_pkg.sv]
2021-05-20 Update rc.sv
    implemented RC input and output interfaces , buffers , state machines ,and the MAS diagram.
    still missing the control signals
    [rc.sv]
2021-05-24 add start of prime factoring code
    * setup code: initialize global section with hardcoded input
    * initialize master and workers
    * exit from setup only after master is done
    * how to pass argument (currently hardcoded)
    * implement loop (how to modulus?)
    * implement loop: workers report result, master polls
    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
2021-05-25 1.Fixed linker 2.memory access fixed with ABD 3.script move files to alive dir + can run with 1 argument 4.add trackers and assersions
    [core_4t.sv, d_mem_wrap.sv, gpc_4t_param_pkg.sv, gpc_4t_tb.sv]
2021-05-27 add global setup entry point
    * define entry point in header
    * implement usage (up to actual bootstrap vs. other threads)
    * add corresponding definitions to library
    * adjust sample apps to new entry points
2021-05-27 implement prime factoring
    * global init with input in global memory
    * local init each thread with local data as well
    * implement worker
    * manager polls workers and updates state
    * workers update state in global data, local data used for algorithm
    * implement modulus (currently doesn't link)
    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
2021-05-31 dynamically calculate memory layout
    current layout:
    1/8 global
    21/128 local (total 84/128)
    7/128 stack (total 28/128)
    more improvements:
    * add header with cr offsets
    * use stack to store calculated sizes
    * use less temp registers - step towards rv32e support
    * clear stack when done - save stack space for user
    * more flexible layout (compile time?)
    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
2021-06-12 Update rc.sv
    implemented , matrix is still missing
    [rc.sv]
2021-06-15 cr enabling + folder arrenge + shrdmem tracker + script enhancement +many fixes
    [core_4t.sv, d_mem_wrap.sv, gpc_4t.sv, gpc_4t_param_pkg.sv]
2021-06-17 Libgpc (#84)
    * restructure library code
    * src/apps -> examples/
    * src/lib -> src/
    * remove helpers.c (unused file)
    * define memory layout at build time
    * add gpc_memory_layout.h to describe memory layout with macros (default values)
    * create gpc_params_t, struct with GPC parameters
    * steal sizeof(gpc_params_t)*4 bytes from global data for GPC params per thread
    * update entry point to take build time defined offsets and sizes
    * update app entry point signatures to get pointer to gpc_params_t
    * add support for .rodata section in global data
    add .rodata section into global data in compile time
    * add global variables support
    open: doesn't link if .bss is placed inside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
2021-06-21 Libgpc (#92)
    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
2021-06-22 ps script tu run multiple simulations + crt0 cleanup + d_mem_wrap bug fix + enabling multiple tests on TB
    [d_mem_wrap.sv, gpc_4t_tb.sv]
2021-06-22 implement global setup handler synchronization
    add tentative scratchpad register offsets to cr header
    use scratchpad0 to synchronize execution:
    bootstrap thread invokes setup handler and writes 1 to scratchpad0
    other threads wait until scratchpad0 is not zero
    scratchpad0 is guaranteed by hw to be zero on reset
2021-06-22 pad text segment with zeroes
    when loaded into i_mem, this will force unused data to be zero.
    zero seems to be an unsupported compressed opcode ("unimp" in disassembly), which makes the execution deterministic in case PC goes out of range
2021-07-06 fix typo in branch(AluIn1Q102H<AluIn1Q102H) (#119)
    [core_4t.sv]
2021-07-06 fix parameter MSB_CR = 11;
    [gpc_4t_param_pkg.sv]
2021-07-07 add sanity check in empty.c example
    * stall in global setup (read thread id 50 times)
    * initialize SCRATCHPADi in local init
    * increment SCRATCHPADi in loop
2021-07-07 Rc update (#126)
    * RC UPDATES
    * rc updates
    * fixed comments from git
    [mro.sv, rc.sv, rc_tb.sv]
2021-07-07 Fix compilation and elaboration of rc.
    [gpc_4t_log_gen.sv, gpc_4t_tb.sv, lotr_defines.sv, mro.sv, rc.sv, rc_tb.sv]
2021-07-20 Abd commit test prime_factor (#135)
    * fix data mem backdoor load to test
    * commit test prime_factoring
    [gpc_4t_tb.sv]
2021-07-28 Small fix abd (#136)
    * dont read backdoor Data_mem in init
    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
    [core_4t.sv, gpc_4t_log_gen.sv, gpc_4t_tb.sv]
2021-08-11 Rc 11 aug (#138)
    * all fixes in RC according to review
    * modify git ignore to ignore running dir
    [lotr_pkg.sv, rc.sv, rc_tb.sv]
2021-08-11 Small fix abd (#139)
    * fix bug in cr_mem
    * remove the -running_dir- (from rc project)
    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
    [cr_mem.sv]
2021-09-29 Enhancement adlv (#148)
    * EBREAK+goldem_mem+sim_script_enhancement+compile_script_enhancement
    * Update tbsim to show diff and to run gui
    * chronology to crt0
    * GPC_4T issues resolve
    [core_4t.sv, gpc_4t_log_gen.sv, gpc_4t_tb.sv]
2021-09-29 Saar 8.9.21 (#149)
    * Multi_Core
    * Multi_Core_Thread
    * Fix
    Remove brakes not in loops
2021-10-02 Abd lotr integration (#151)
    * RC - F2C only.
    * Clean Compile and Elaboration on the LOTR intergation
    * Fix rc test
    [gpc_4t_tile.sv, lotr.sv, lotr_tb.sv, rc.sv, rc_tb.sv]
2021-10-27 fix core to enable thread freeze
    [core_4t.sv]
2021-10-27 thread stack address as define
2021-11-03 DRAFT : GPC_4T_Eמ_C2F_PreTested
2021-11-05 Fix Changes RC to support RD_RSP from Cores Fix timescale for simulation
    [gpc_4t_tb.sv, lotr_pkg.sv, lotr_tb.sv, rc.sv]
2021-11-05 Fix the RC - split rc to new small moduls f2c & c2f
    [c2f.sv, f2c.sv, rc.sv]
2022-05-25 add std 10 bits to thread number on tile + log enhancement
2022-06-09 bugfix + fpga + tests
    [DE10Lite_MMIO.sv, c2f.sv, fpga_tile.sv, lotr.sv, lotr_pkg.sv, rc.sv]
2022-06-14 Insert mif file (not hex) to FPGA I_MEM.
2022-06-14 (1) Alive_fpga_inst_mem_rv32i.mif: manualy fixed the file to be little_endian (2)pll_50Khz.v New very slow PLL for FPGA testing coutner. (3)
    [top.sv]
2022-06-20 test blinks leds + fix for little endian script
    [lotr.sv, top.sv]
2022-07-07 fix QCLK50 and Alive VGA
    [DE10Lite_MMIO.sv, fpga_tile.sv, lotr.sv, lotr_tb.sv]
2022-07-10 fix VGA simulation offset
    [lotr_tb.sv, vga_ctrl.sv, vga_mem.sv]
2022-07-10 4 threads writing to display HI
2022-07-10 print spaces not _ for dispaly simulation
2022-07-10 FIX size of VGA read port
    [vga_ctrl.sv, vga_mem.sv]
2022-07-17 Enable print (using int array and not char arrays)
2022-07-21 Enalbe Arduino io to MMIO CR + simple test with VGA
2022-07-23 small fix in print snake game
2022-08-02 UART Place holder
2022-08-03 adds Uart, and wishbone documents
2022-08-03 adds UART rtl design files and file list
2022-08-03 updates file uart_io file list
2022-08-08 Fix mem alignment for lh lb, sh, sb (load store - half, byte)
    [core_4t.sv]
2022-08-08 adds connections between design units, interface, interrupts and IO port declertion
2022-08-08 adds tb initial task, updates port connections on uart_io module
2022-08-08 instrumental files to be removed at the end of dev stage, makes compilation and simulation easier
2022-08-10 adds RC F2C and C2F interface. adds TB support for MSB first uart transmissions
2022-08-11 fix stack vs mem offset in compile_link script. Use Parameter in CR_mem
    [cr_mem.sv, lotr_pkg.sv, lotr_tb.sv]
2022-08-11 re-compile all test using new linker fix shrd_mem_snapshot offset
    [gpc_4t_tb.sv]
2022-08-16 graphic lib for printing. New Cr for cursor per thread
2022-09-05 super 8 threads sorting
2022-09-16 UART config FSM
2022-11-12 Adds python code for Uart terminal, and emulation code acting as a slave
2022-11-18 adds testbench emulation of write transfer on the uart line
2022-11-18 adds uart tile module
2022-11-27 UART config bug fix
    [uart_config.sv]
2022-12-02 adds uart integration to FPGA target, cleans lach logic, and compilation errors
    [gateway.sv, lotr.sv, top.sv, transfer_handler_engine.sv, uart_config.sv, uart_io.sv, uart_tile.sv]
2022-12-03 adds uart interrupt to LED9 for demonstartion, successfull integration
2022-12-06 Connects UART tile to the ring
2022-12-11 fixes ack timout num, adds gateway selector logic
    [gateway.sv, uart_term.py]
2022-12-12 Adds error and warning fixes
    [c2f.sv, lotr.sv, lotr_tb.sv]
2022-12-24 Updates UART buad rate to 115200, adds UART transfers on lotr_tb env with a simple LED test WORKS!
2023-01-07 Adds minor Burst bugfixes on terminal side
    [file_parser.py, lotr_tb.sv, uart_term.py]
2023-01-08 bugfix in transfer handler engine
    [transfer_handler_engine.sv]
2023-01-08 bugfix in uart term
    [uart_term.py]
2023-01-08 signal cleaning reverts LED functionality to original
    [lotr.sv, top.sv]
2023-01-19 test and create seqeunce for uart WB/W to use uart to configure different tests on the FPGA.
2023-01-28 Fix the snake game to allow restart with switch 7
2023-03-02 Enable GCC riscv sw compilation, hw vlogan compilation, hw elaboration & simulation + Post procces run script Currently something is wrong in the run itself - error flad log is set.
2023-03-08 Fixed the mem.sv generated split inst & data
    [gpc_4t_log_gen.sv]
2023-03-14 support printing int + lotr test
2023-03-15 uart alive test enabled
2023-03-29 Fix linker to generate only full 32 bit data
    [lotr.sv]
2023-06-11 Bug fix: close #277 - redundent responce when writing to DE10lite_mmio close #276 - wrong mro age matrix calc - use use a bitwise for calculating the enable shift
    [DE10Lite_MMIO.sv, mro.sv]
