amichai-bd/riscv-multi-core-lotr/(notices)

Notices in the files:
source/uart_io/rtl/uart/uart_regs.v:
Copyright (C) 2000, 2001 Authors
Public License as published by the Free Software Foundation;
Public License along with this source; if not, download it
from http://www.opencores.org/lgpl.shtml
